mar0x/pq-4/img/pq-4/IMG_7533 copy.png

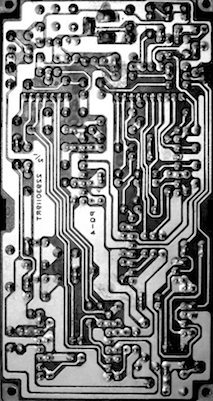
img/pq-4/IMG_7533 copy.png
