mar0x/pq-4/doc/DS-5-02A-MIDI-socket.jpg

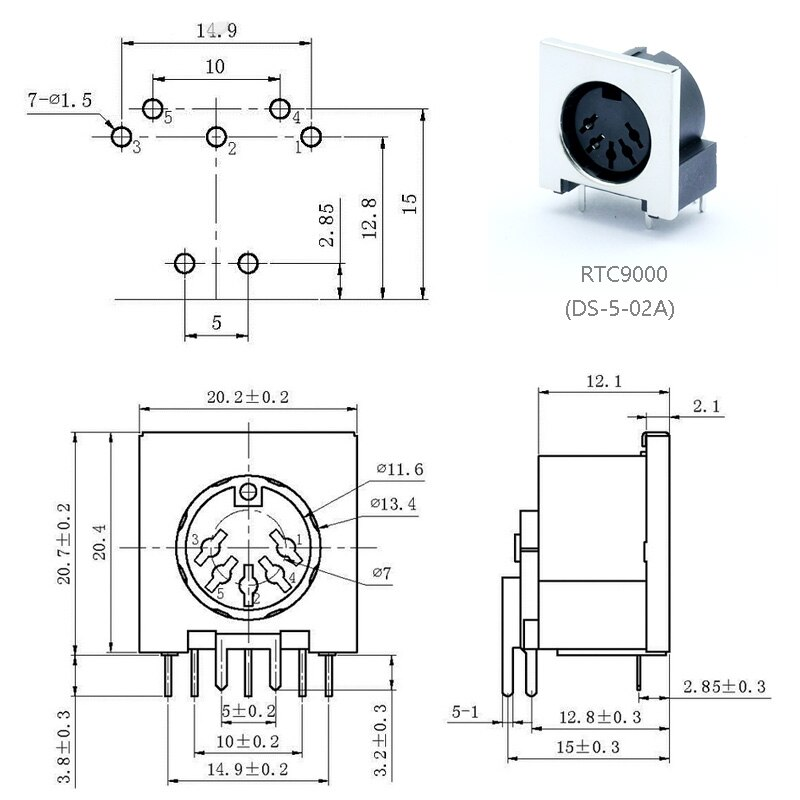
doc/DS-5-02A-MIDI-socket.jpg
