mar0x/pq-4/doc/pq-4-original.png

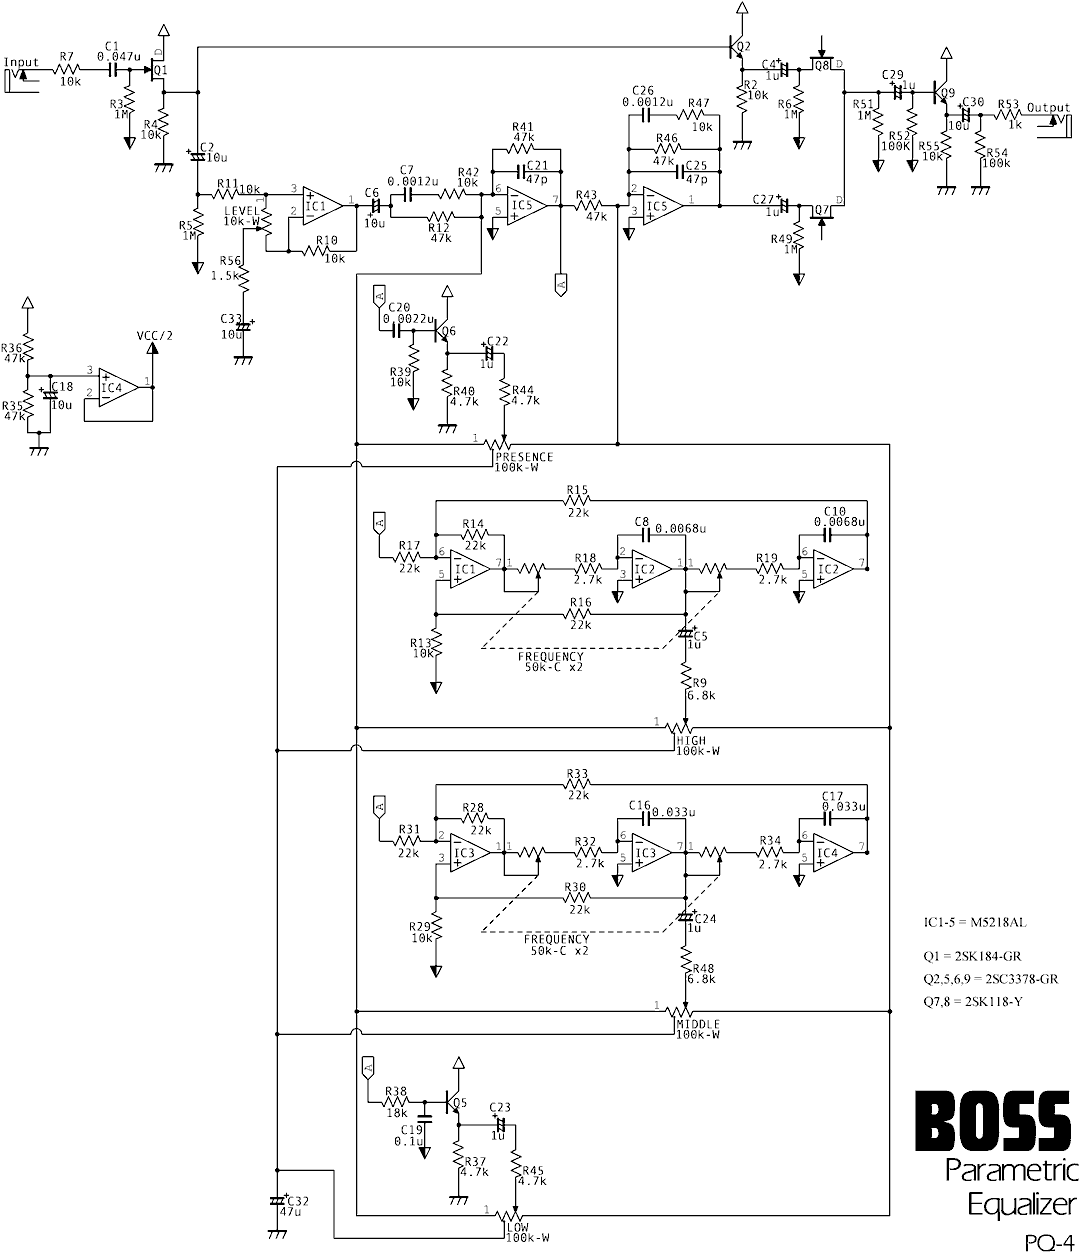
doc/pq-4-original.png
