mar0x/pq-4/img/digi_pot_20191016_101719.jpg

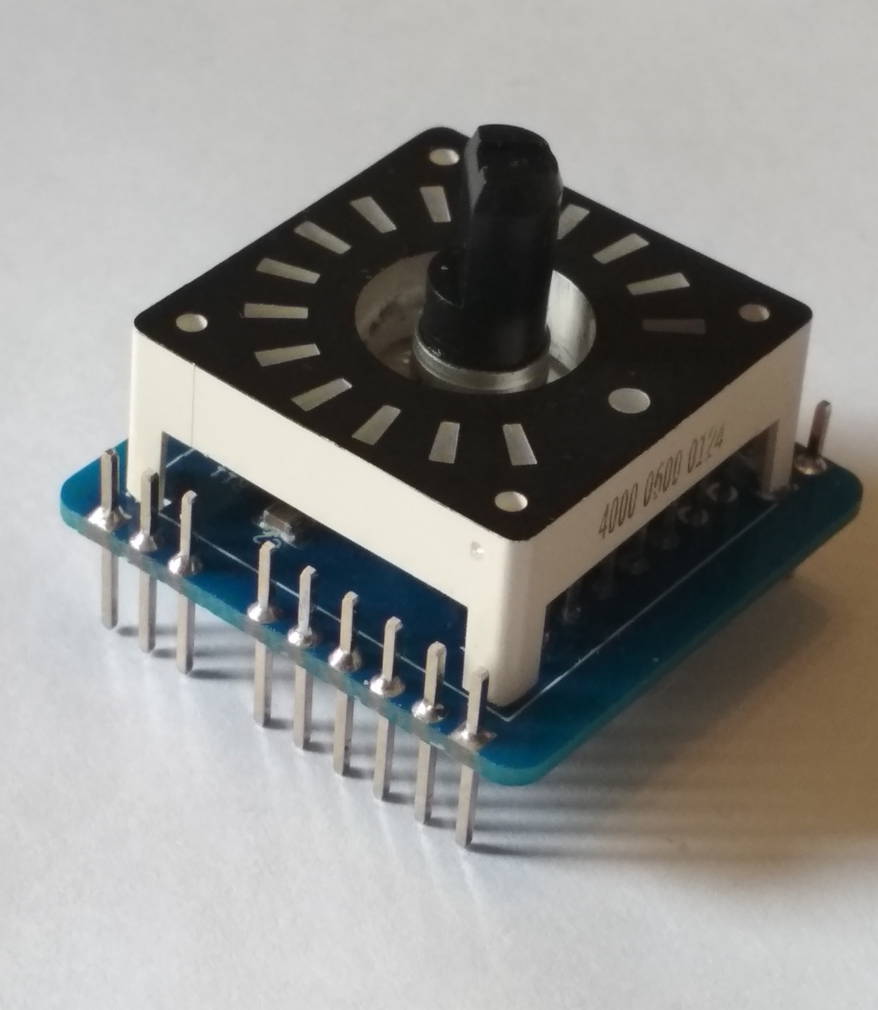
img/digi_pot_20191016_101719.jpg
