mar0x/pq-4/img/digi_pot_20191017_182157.jpg

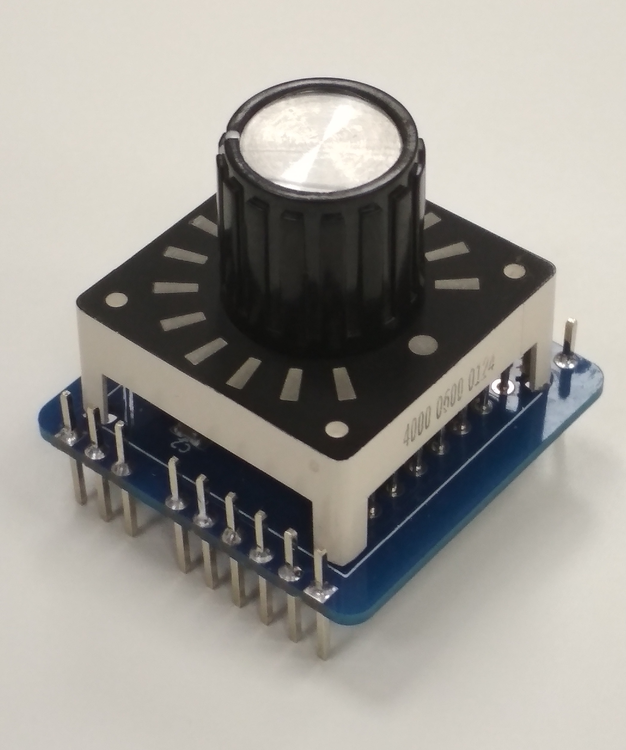
img/digi_pot_20191017_182157.jpg
