mar0x/pq-4/img/double_pot_vs_digi_pot.jpg

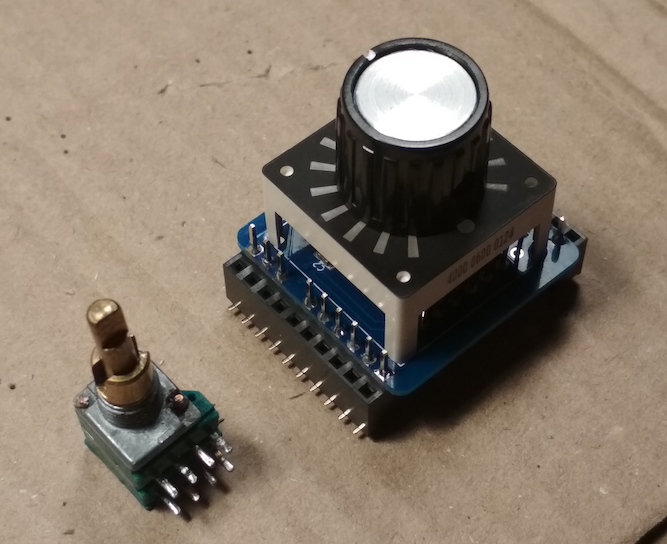
img/double_pot_vs_digi_pot.jpg
