mar0x/pq-4/img/drill.png

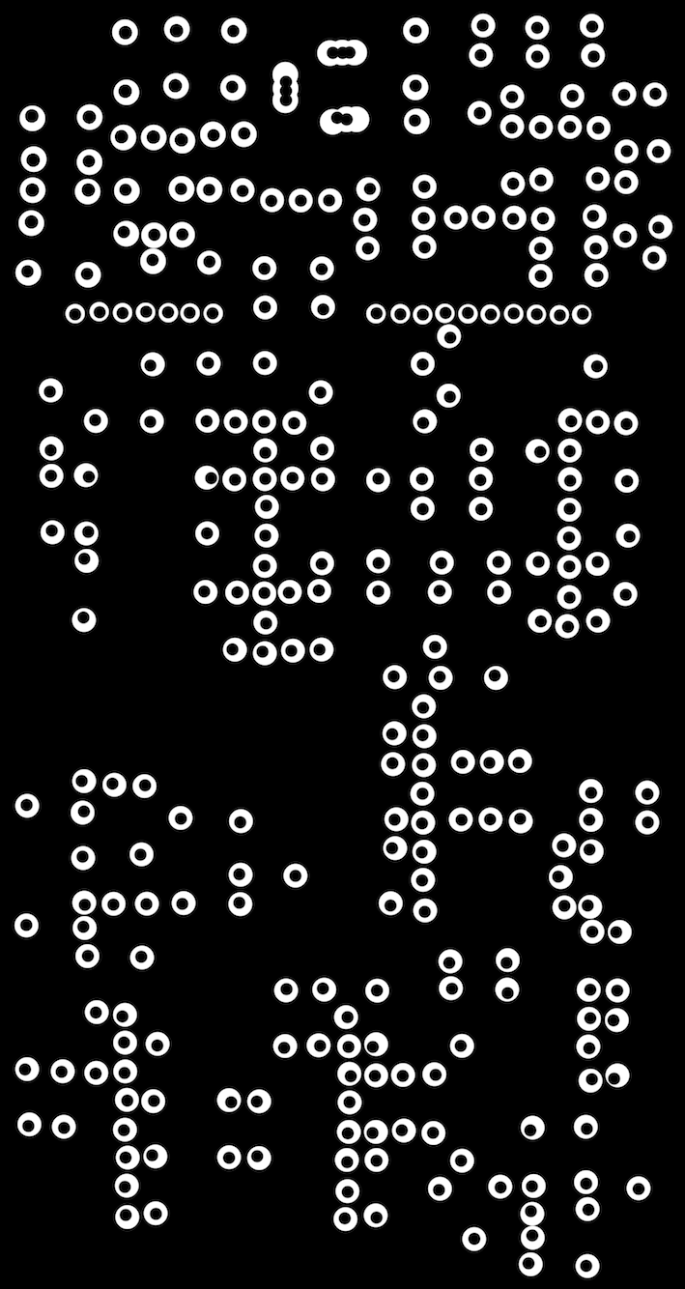
img/drill.png
