mar0x/pq-4/img/layout_v01.jpg

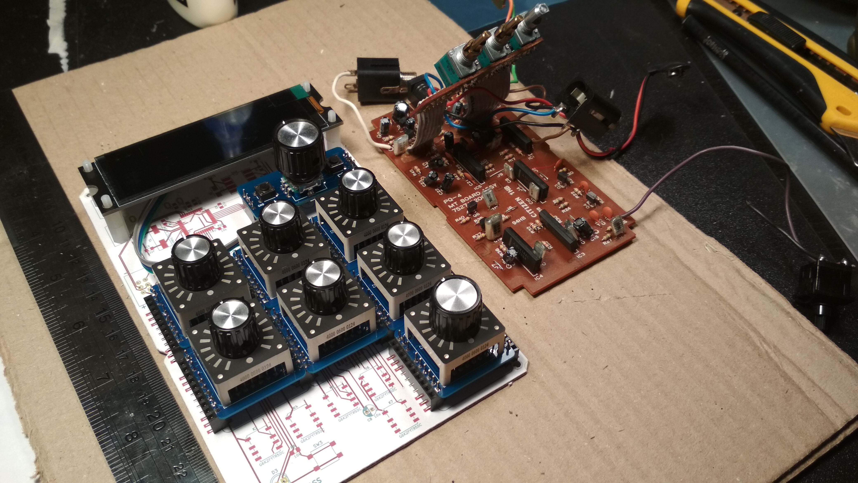
img/layout_v01.jpg
