mar0x/pq-4/img/pq-4/IMG_7537.JPG

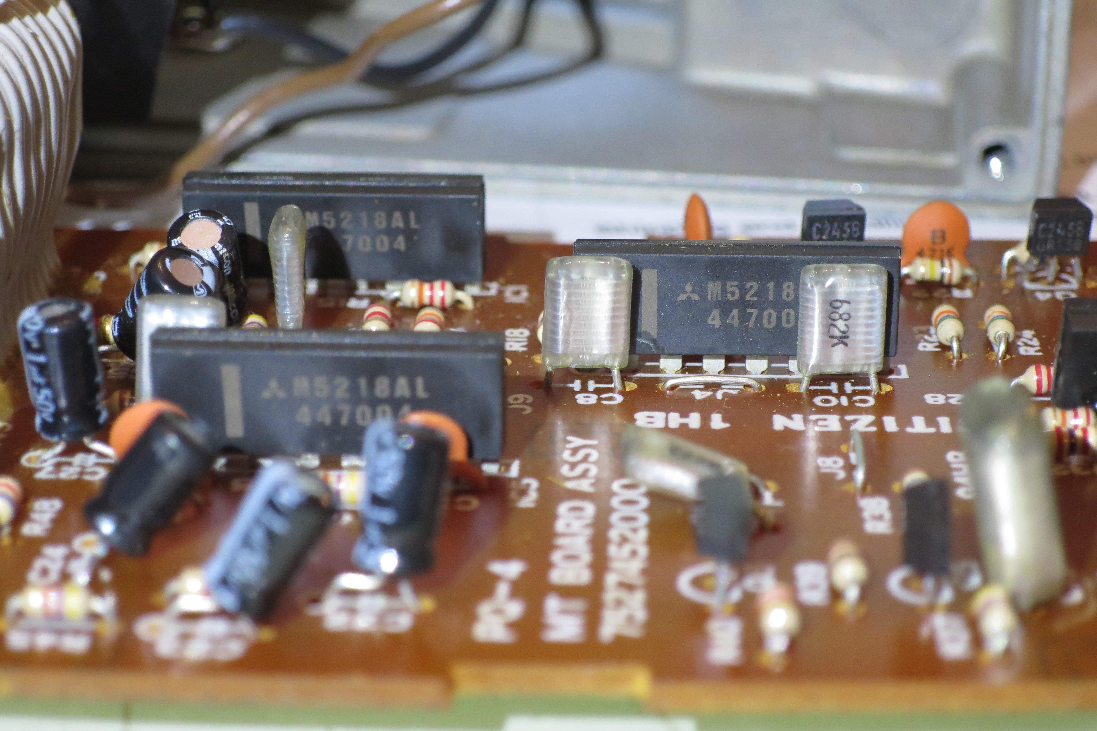
img/pq-4/IMG_7537.JPG
