mar0x/pq-4/img/pq-4/IMG_7544.JPG

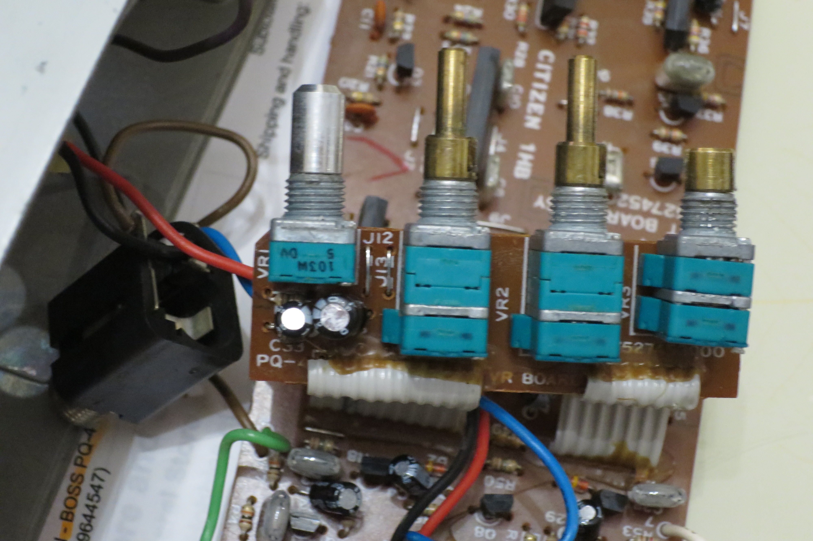
img/pq-4/IMG_7544.JPG
