mar0x/pq-4/img/pq-4/PICT0001.jpg

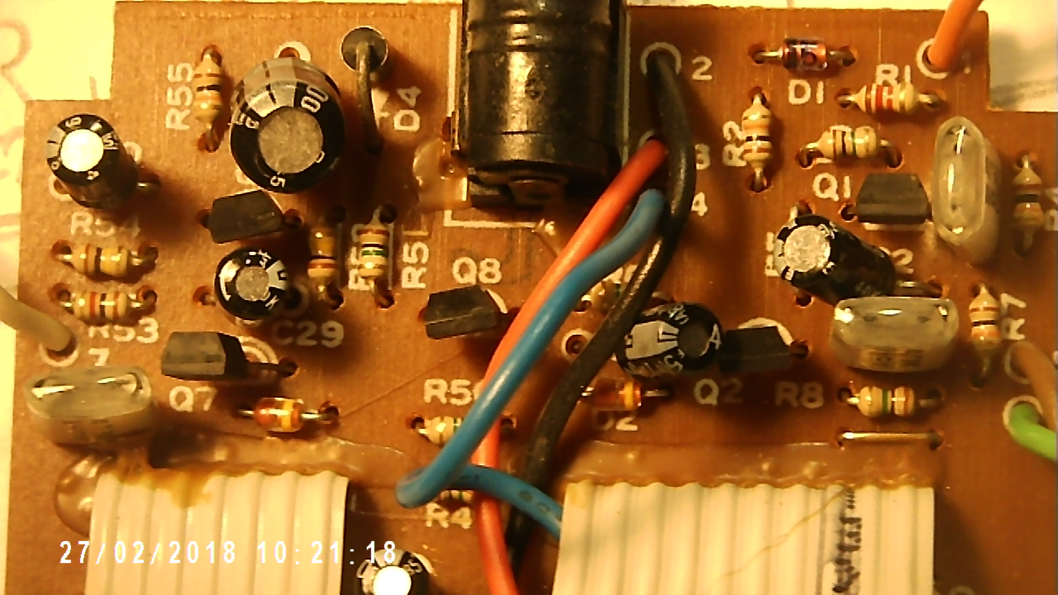
img/pq-4/PICT0001.jpg
