mar0x/pq-4/img/pq-4/PICT0008.jpg

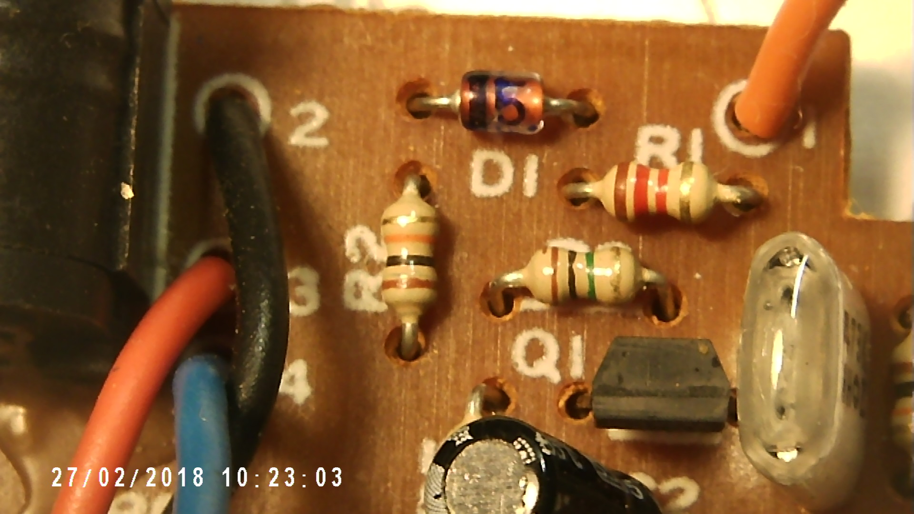
img/pq-4/PICT0008.jpg
