mar0x/pq-4/img/pq-4/PICT0014.jpg

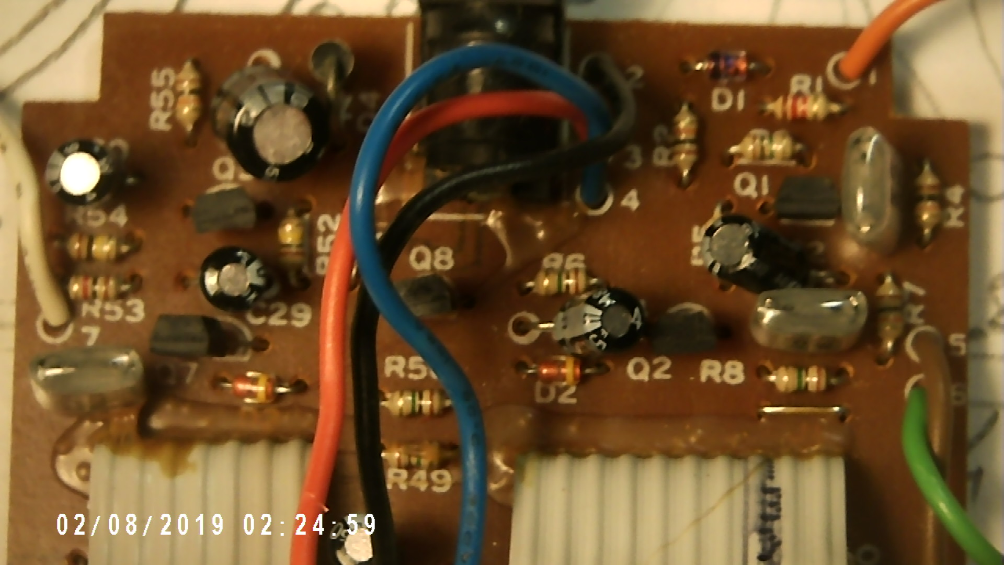
img/pq-4/PICT0014.jpg
