mar0x/pq-4/img/pq-4/PICT0015.jpg

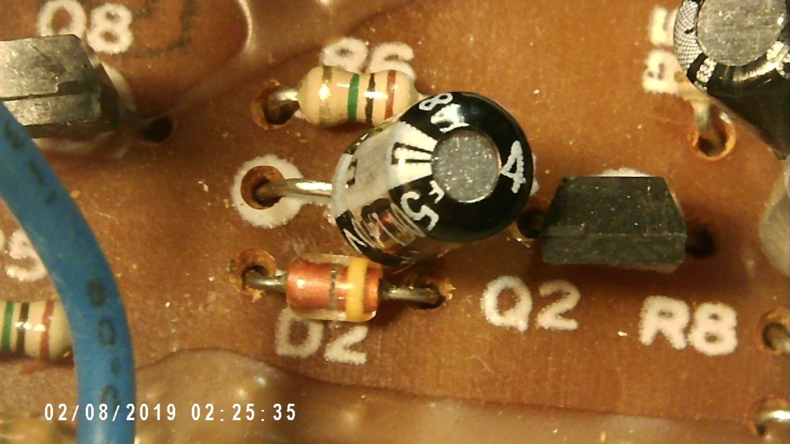
img/pq-4/PICT0015.jpg
