mar0x/pq-4/img/pq-4/PICT0018.jpg

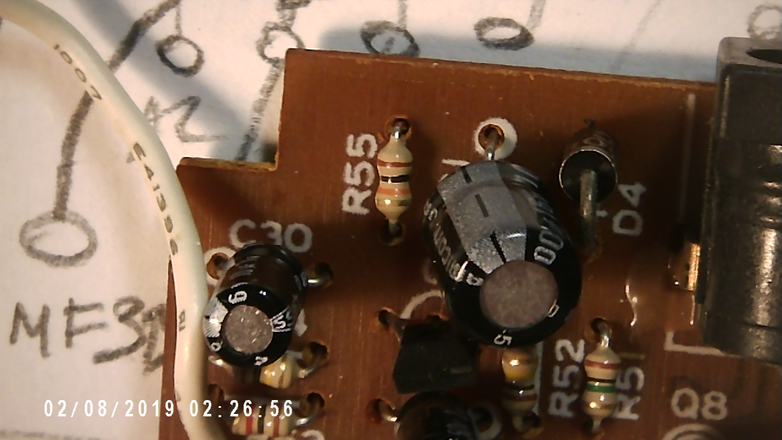
img/pq-4/PICT0018.jpg
