mar0x/pq-4/img/pq-4/PICT0020.jpg

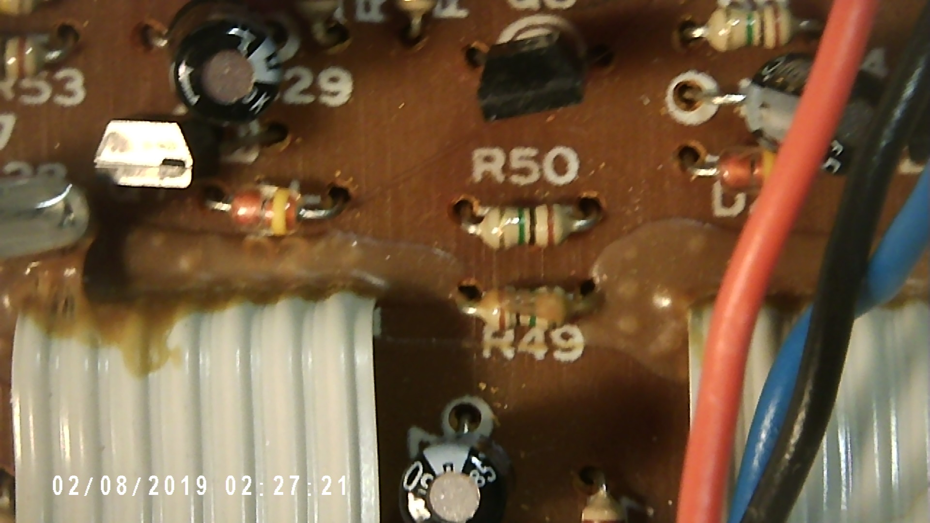
img/pq-4/PICT0020.jpg
