mar0x/pq-4/img/render/digi_pot_bottom.jpg

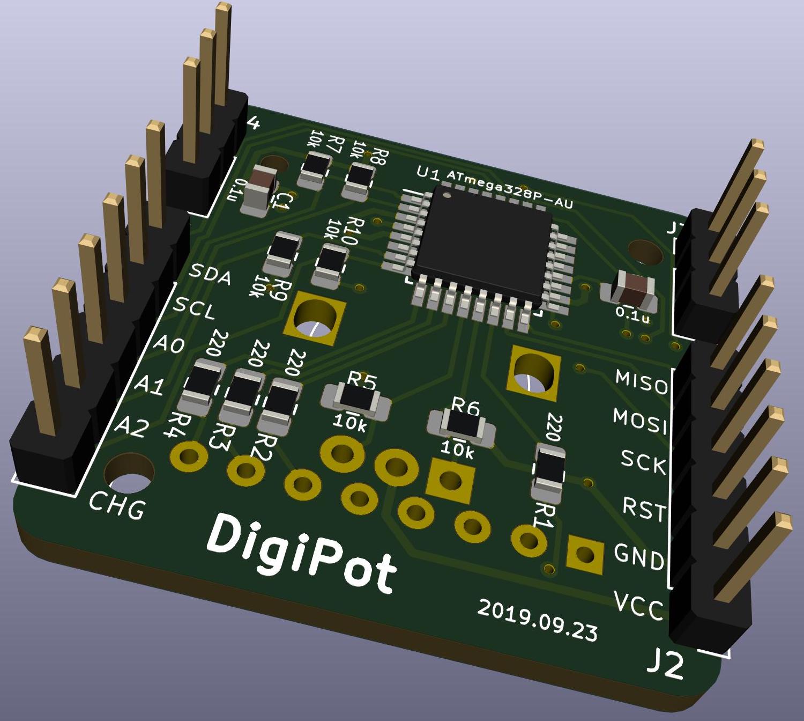
img/render/digi_pot_bottom.jpg
