mar0x/pq-4/img/render/digi_pot_render.jpg

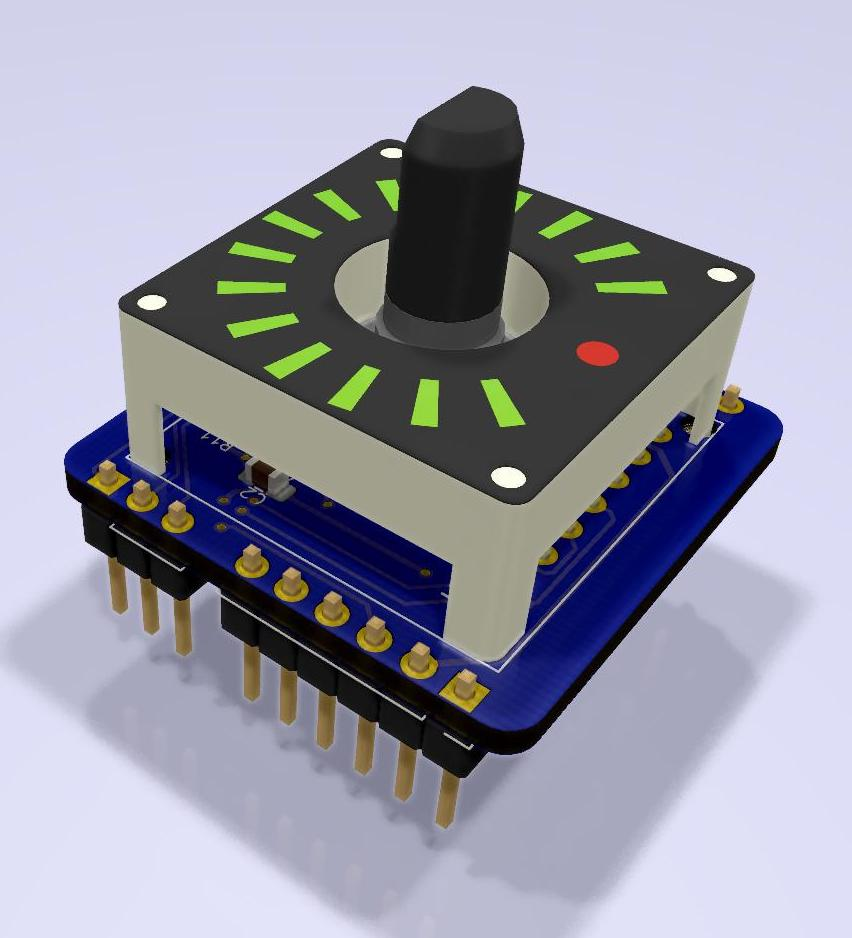
img/render/digi_pot_render.jpg
