mar0x/pq-4/img/render/digi_pot_top.jpg

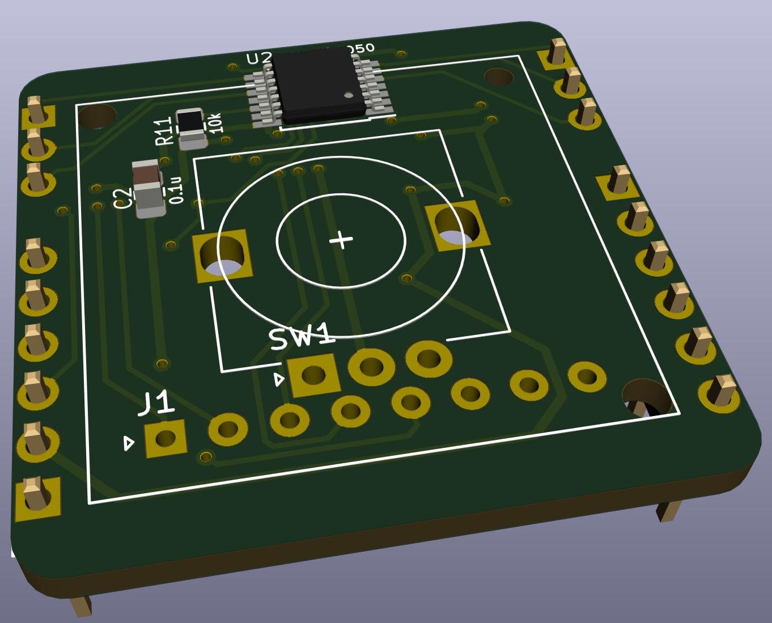
img/render/digi_pot_top.jpg
