mar0x/pq-4/img/render/enc_panel_top.jpg

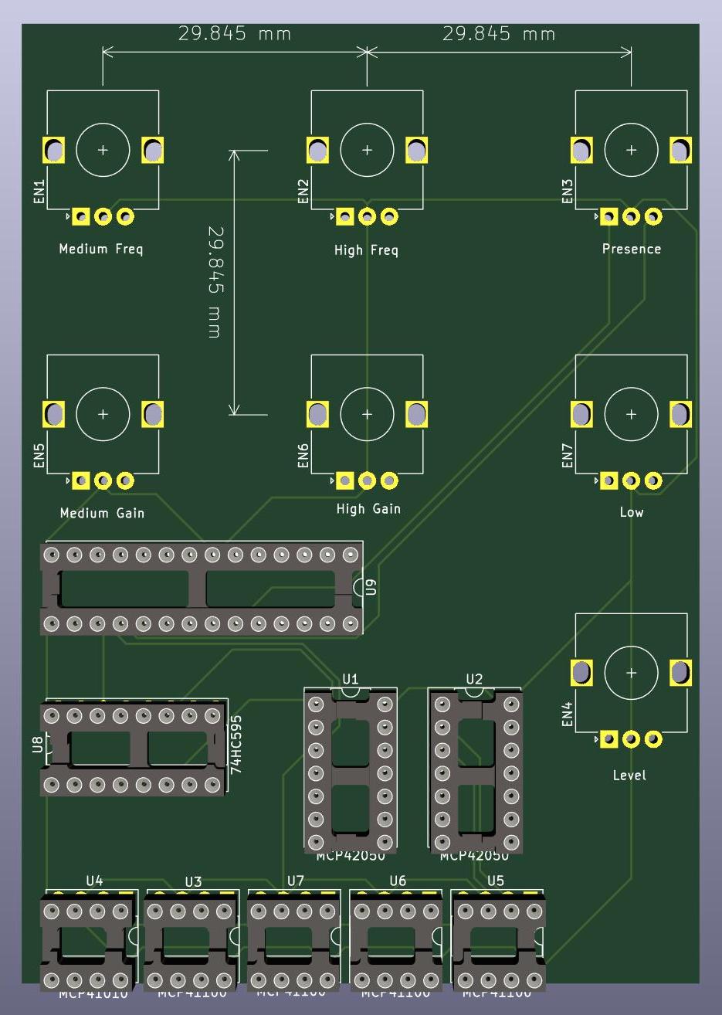
img/render/enc_panel_top.jpg
