mar0x/pq-4/img/render/eval_board_bottom.jpg

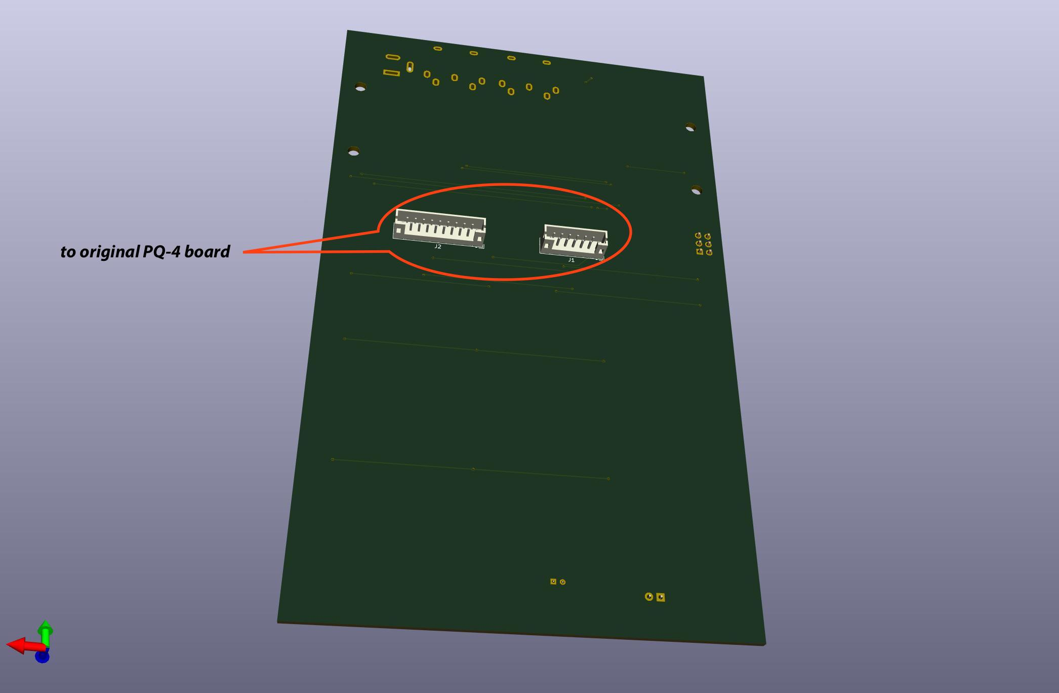
img/render/eval_board_bottom.jpg
