mar0x/pq-4/img/render/eval_board_top.jpg

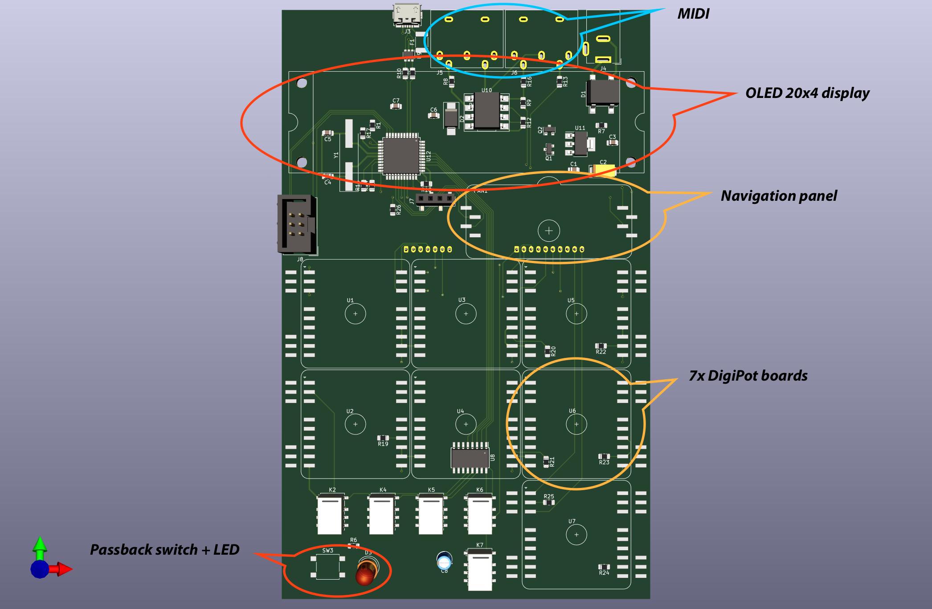
img/render/eval_board_top.jpg
