mar0x/pq-4/img/render/nav_panel_bottom.jpg

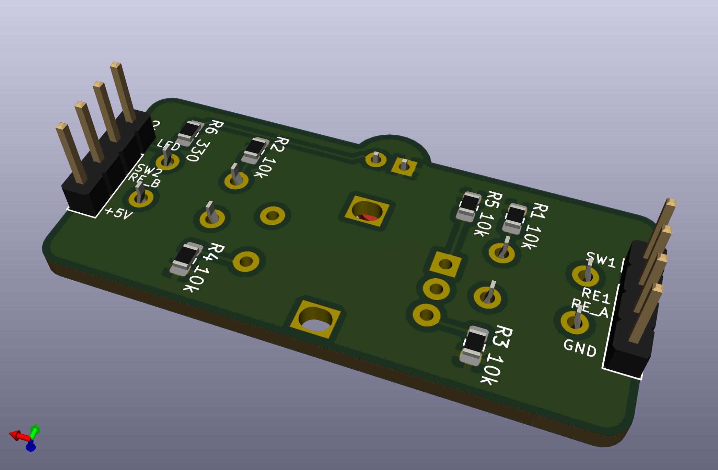
img/render/nav_panel_bottom.jpg
