mar0x/pq-4/img/render/nav_panel_top.jpg

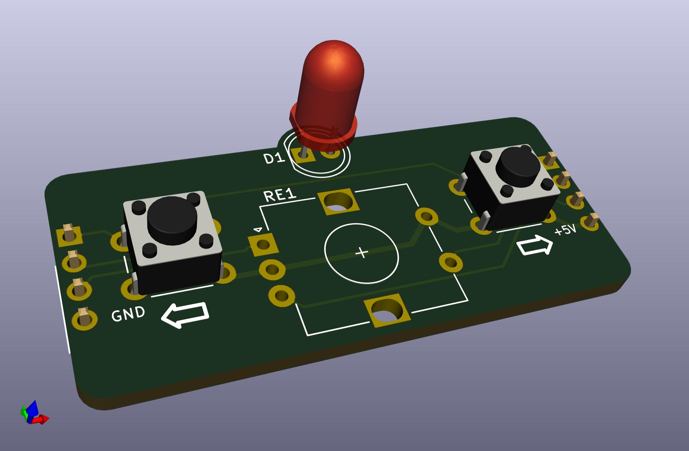
img/render/nav_panel_top.jpg
