mar0x/pq-4/doc/pq-4-replica.pdf

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

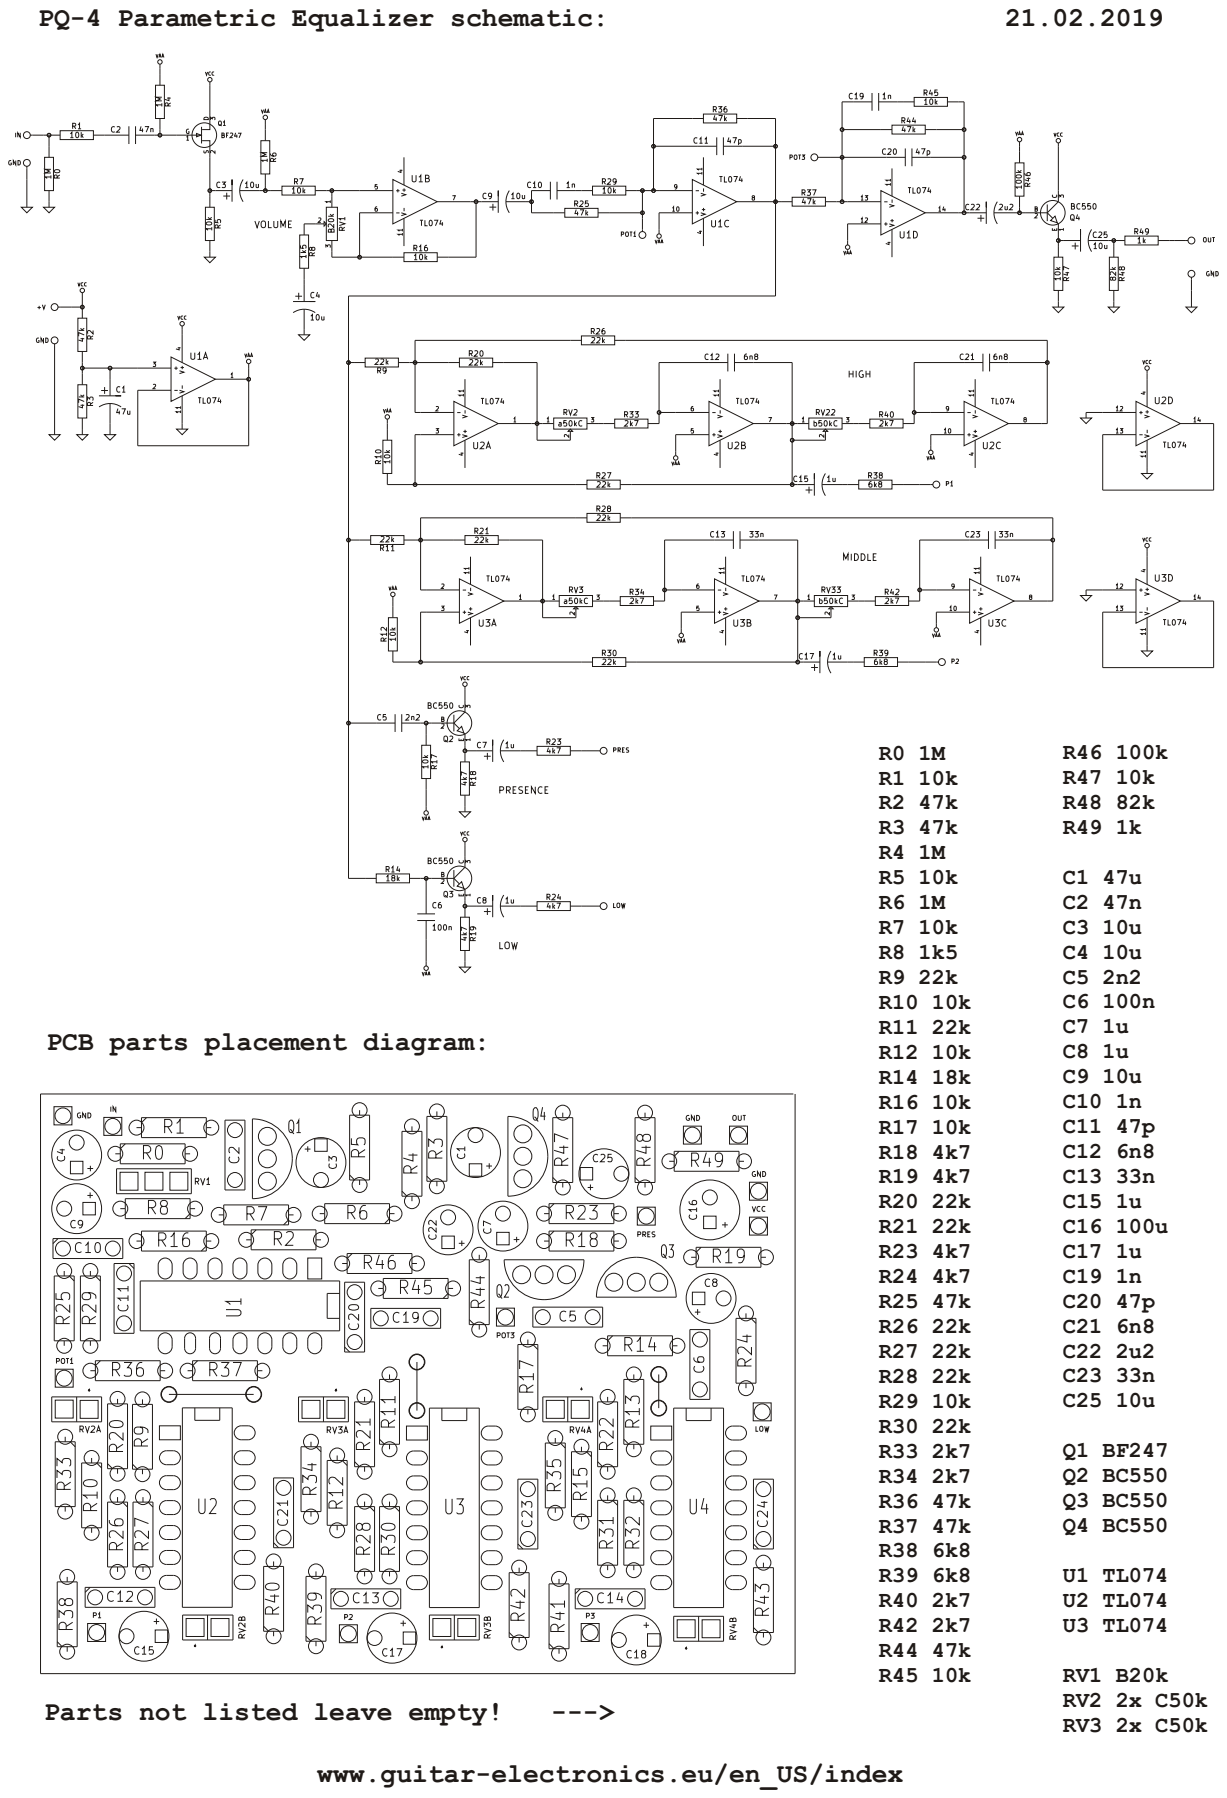
[picture p52: page 1]

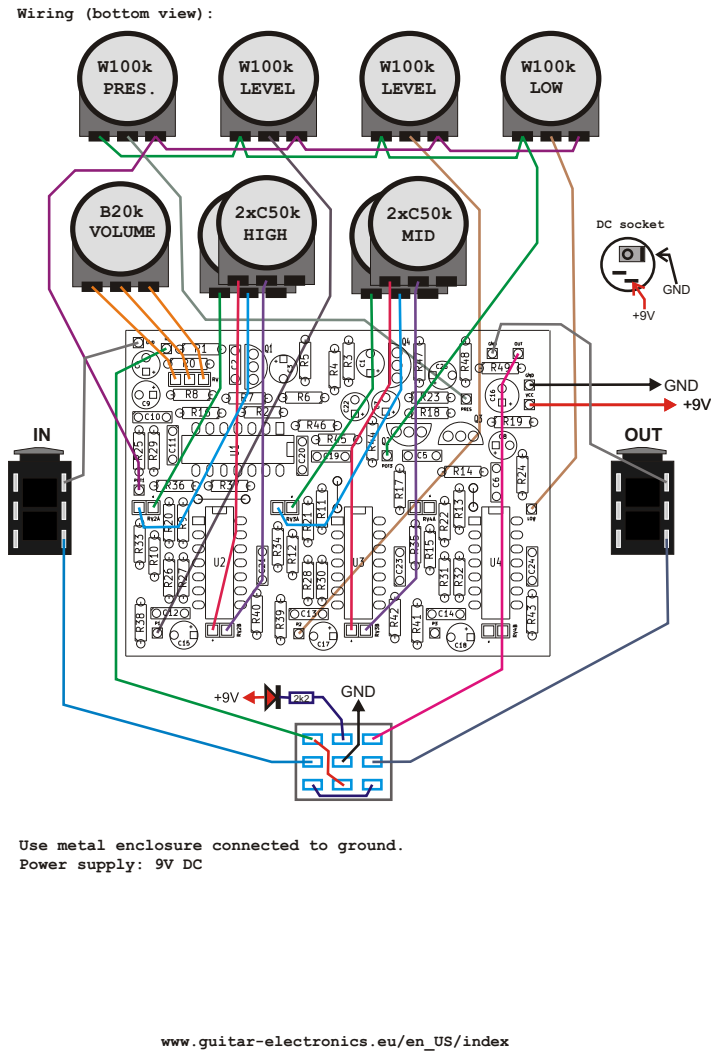
[picture p53: page 2]
W100k LEVEL; GND; 2xC50k MID; W100k PRES.; W100k LOW; B20k VOLUME; 2xC50k HIGH; OUT; DC socket

Wiring (bottom view):

Use metal enclosure connected to ground.
Power supply: 9V DC

www.guitar-electronics.eu/en_US/index

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

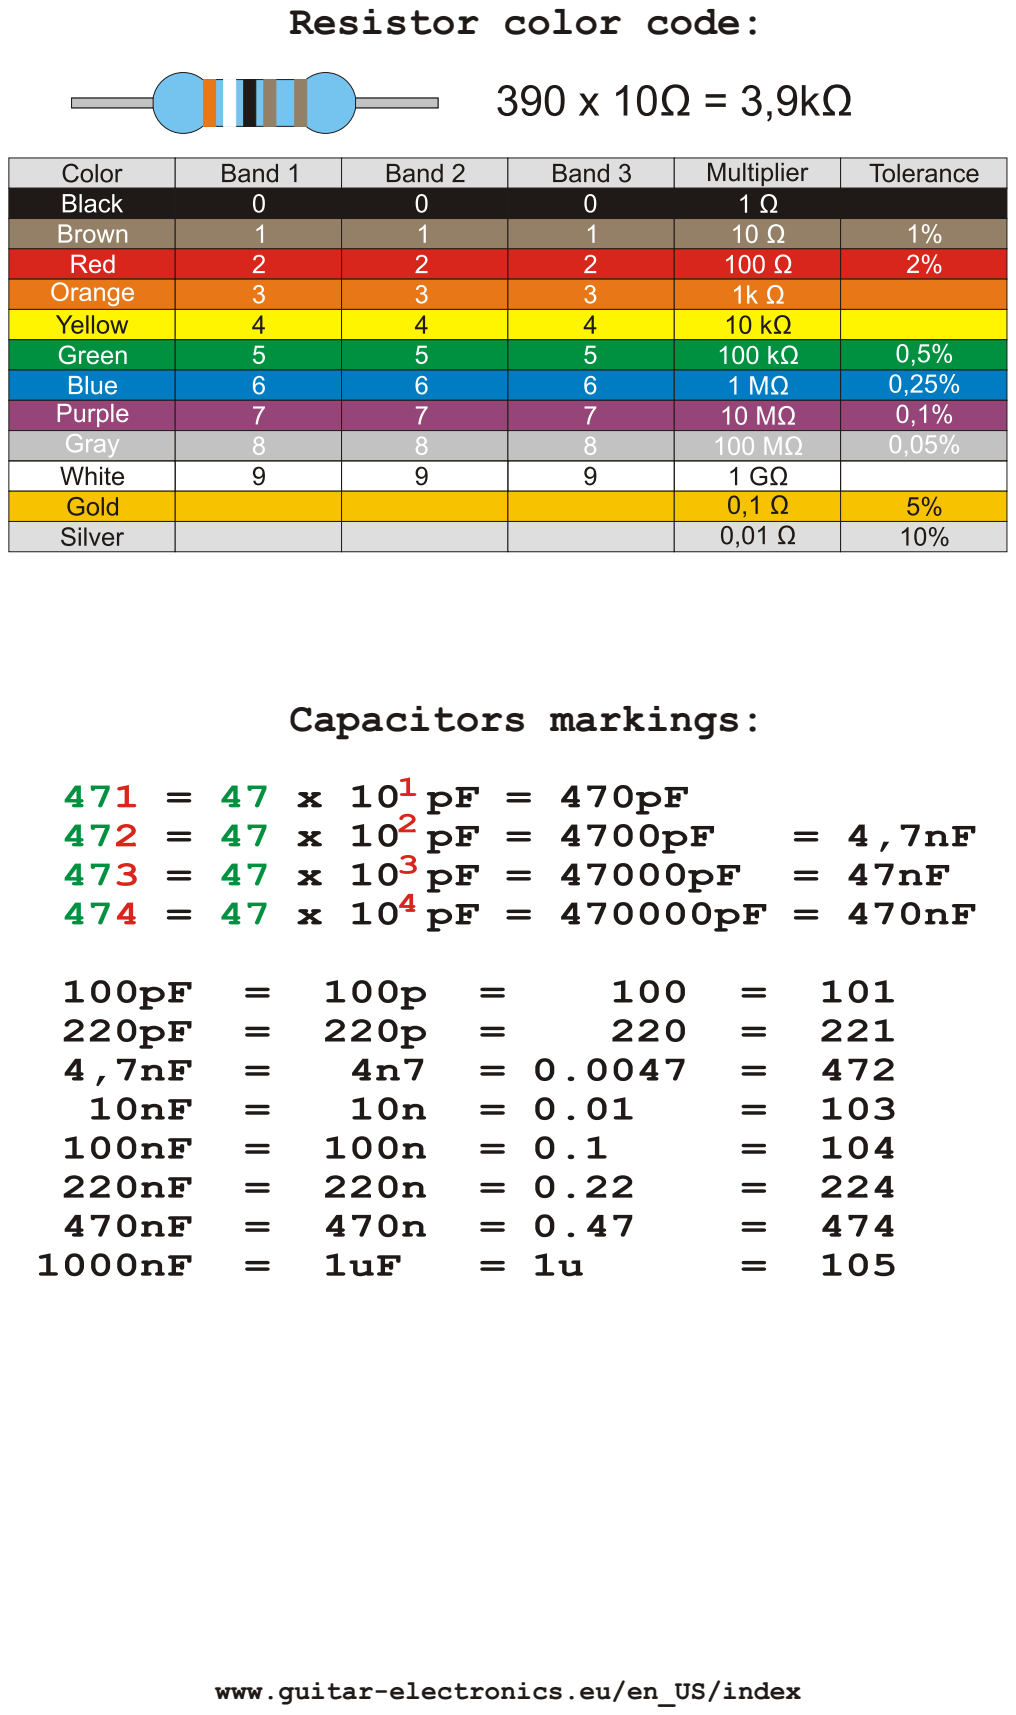
[picture p54: page 4]
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
