mar0x/pq-4/pq-4-schem.pdf

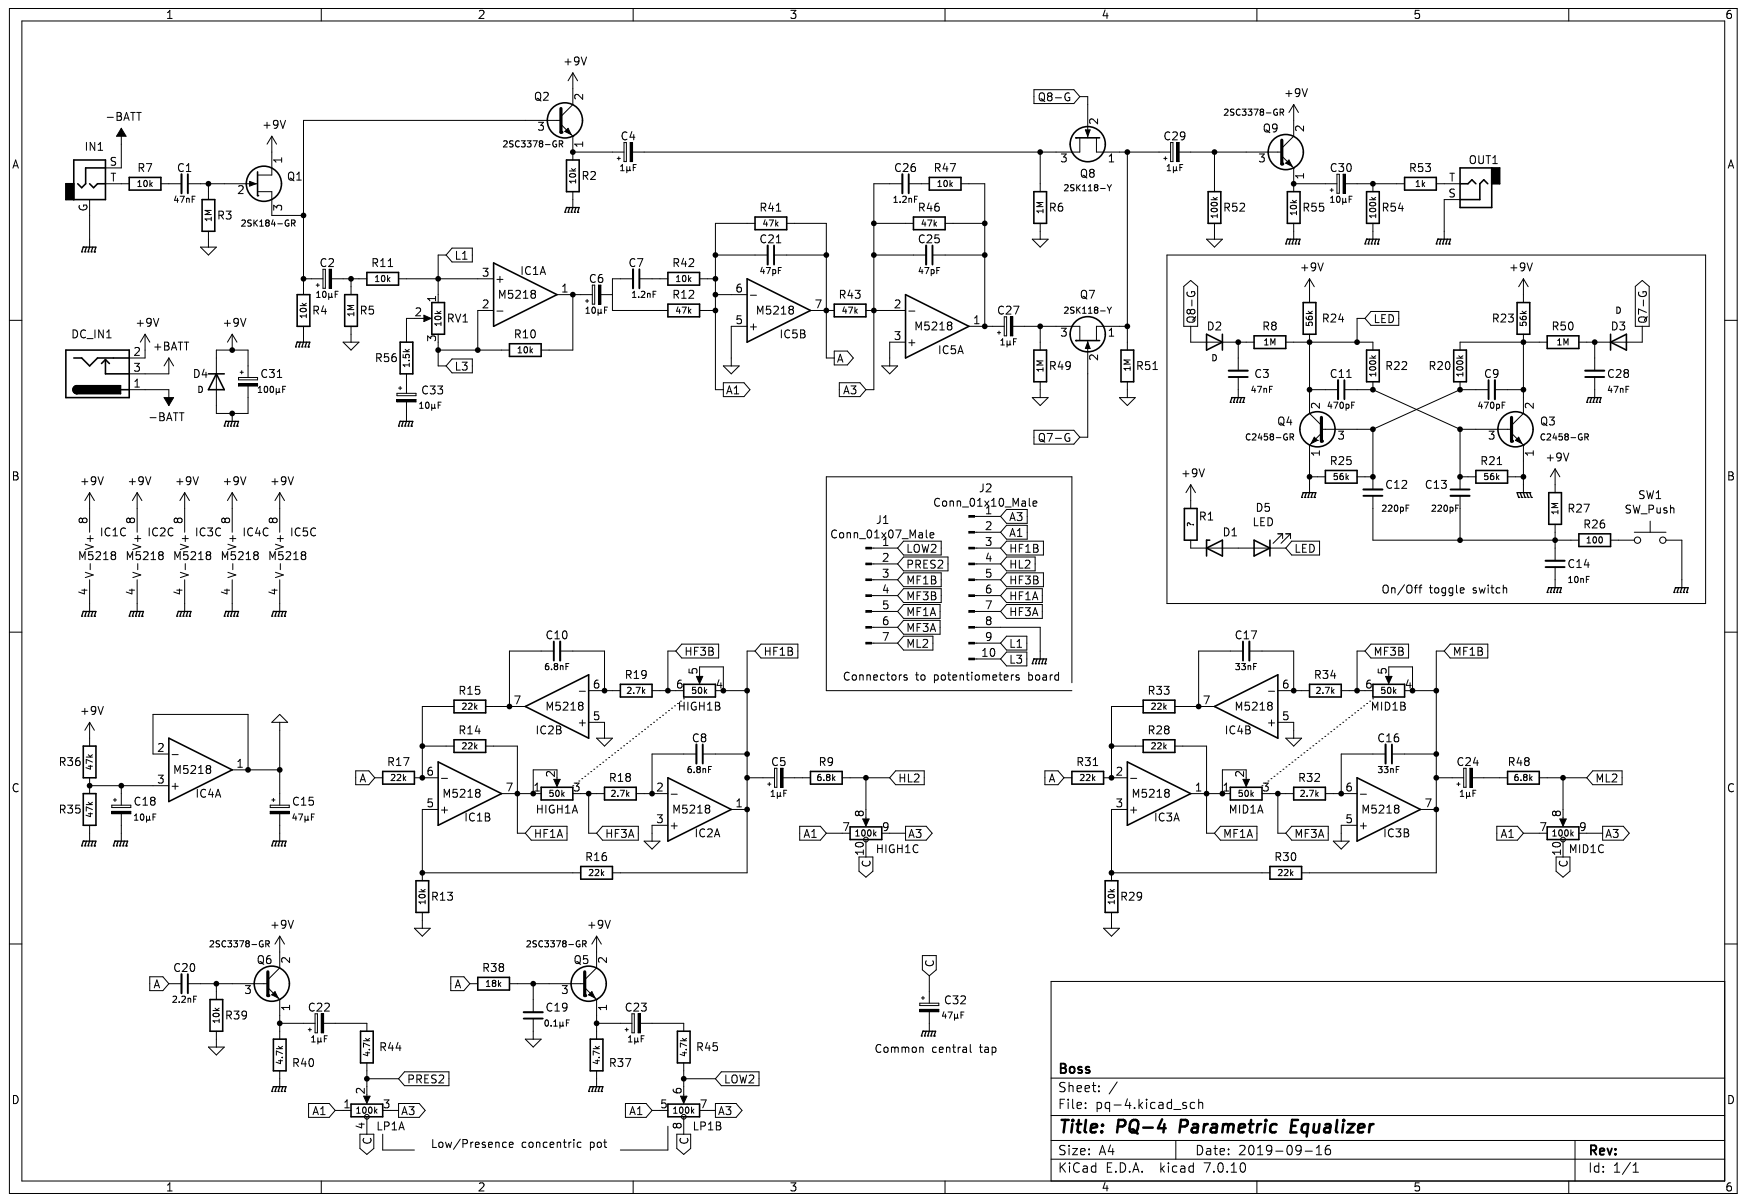
[picture p55: page 1]
