mar0x/pq-4/doc/Парам.экв 10.pdf

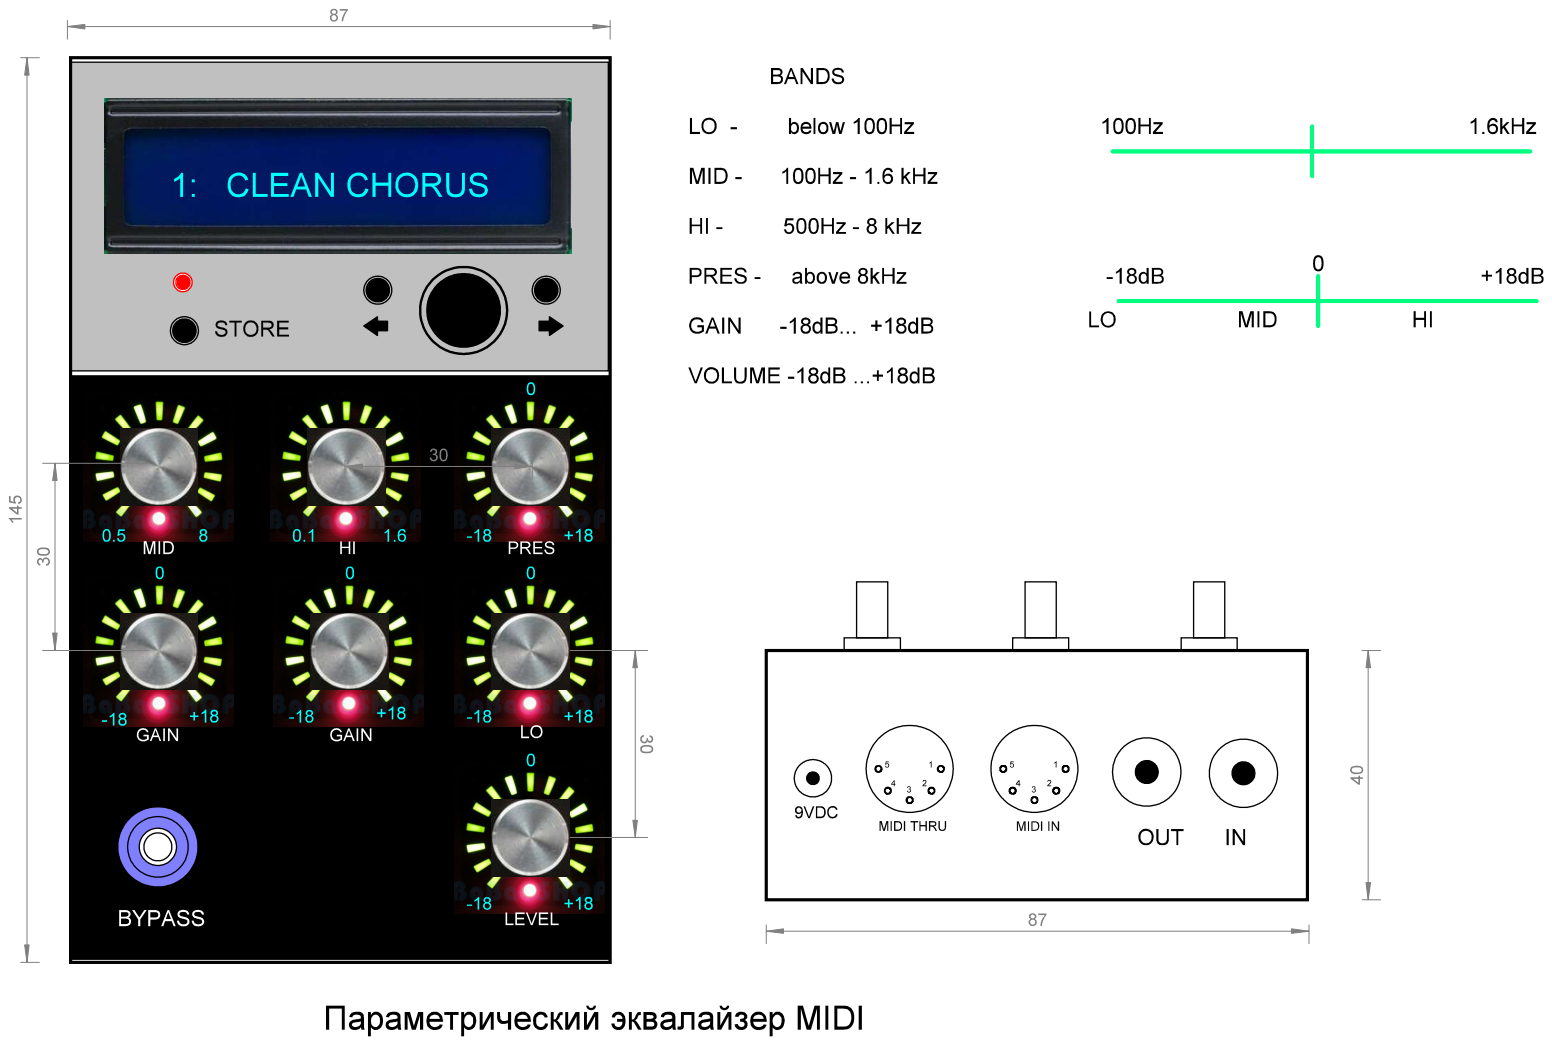
[picture p56: page 1]
