mar0x/pq-4/pot_board/pot_board.kicad_pcb

## KiCad design pot_board/pot_board.kicad_pcb (2024-01-14)

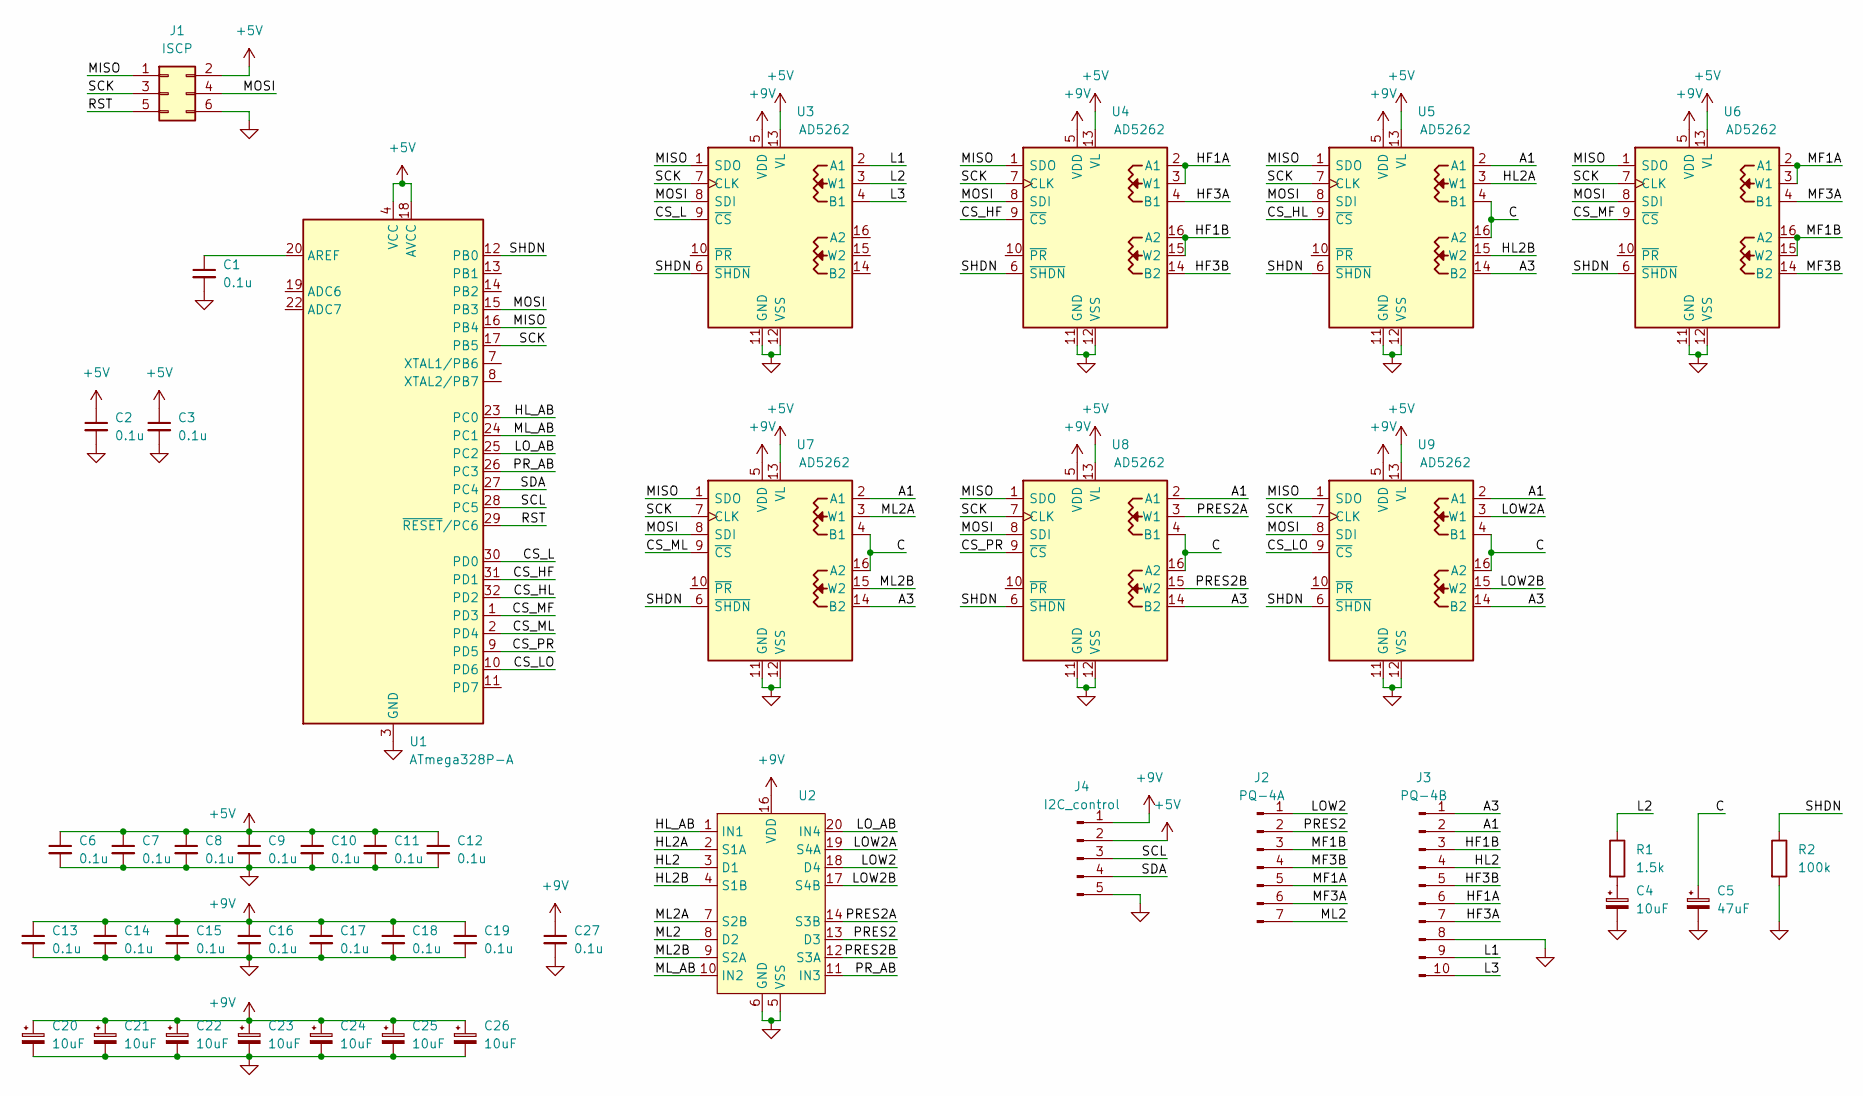
[picture p57: schematic pot_board.kicad_sch]

Parts:
C1, C2, C3, C6, C7, C8, C9, C10, C11, C12, C13, C14, C15, C16, C17, C18, C19, C27: 0.1u; C_0805_2012Metric
C4, C20, C21, C22, C23, C24, C25, C26: 10uF; CP_Radial_D4.0mm_P2.00mm
C5: 47uF; CP_Radial_D4.0mm_P2.00mm
J1: ISCP; IDC-Header_2x03_P2.54mm_Vertical
J2: PQ-4A; JST_PH_B7B-PH-K_1x07_P2.00mm_Vertical
J3: PQ-4B; JST_PH_B10B-PH-K_1x10_P2.00mm_Vertical
J4: I2C_control; JST_PH_B5B-PH-K_1x05_P2.00mm_Vertical
R1: 1.5k; R_0805_2012Metric
R2: 100k; R_0805_2012Metric
U1: ATmega328P-A; TQFP-32_7x7mm_P0.8mm
U2: TSSOP-20_4.4x6.5mm_P0.65mm
U3, U4, U5, U6, U7, U8, U9: AD5262; TSSOP-16_4.4x5mm_P0.65mm

Connections:
+5V: C2.1, C3.1, C6.1, C7.1, C8.1, C9.1, C10.1, C11.1, C12.1, J1.2, J4.2, U1.4 (VCC), U1.6 (VCC), U1.18 (AVCC), U3.13 (VL), U4.13 (VL), U5.13 (VL), U6.13 (VL), U7.13 (VL), U8.13 (VL), U9.13 (VL)
+9V: C13.1, C14.1, C15.1, C16.1, C17.1, C18.1, C19.1, C20.1, C21.1, C22.1, C23.1, C24.1, C25.1, C26.1, C27.1, J4.1, U2.16 (VDD), U3.5 (VDD), U4.5 (VDD), U5.5 (VDD), U6.5 (VDD), U7.5 (VDD), U8.5 (VDD), U9.5 (VDD)
/A1: J3.2, U5.2 (A1), U7.2 (A1), U8.2 (A1), U9.2 (A1)
/A3: J3.1, U5.14 (B2), U7.14 (B2), U8.14 (B2), U9.14 (B2)
/C: C5.1, U5.4 (B1), U5.16 (A2), U7.4 (B1), U7.16 (A2), U8.4 (B1), U8.16 (A2), U9.4 (B1), U9.16 (A2)
/CS_HF: U1.31 (PD1), U4.9 (~CS)
/CS_HL: U1.32 (PD2), U5.9 (~CS)
/CS_L: U1.30 (PD0), U3.9 (~CS)
/CS_LO: U1.10 (PD6), U9.9 (~CS)
/CS_MF: U1.1 (PD3), U6.9 (~CS)
/CS_ML: U1.2 (PD4), U7.9 (~CS)
/CS_PR: U1.9 (PD5), U8.9 (~CS)
/HF1A: J3.6, U4.2 (A1), U4.3 (W1)
/HF1B: J3.3, U4.15 (W2), U4.16 (A2)
/HF3A: J3.7, U4.4 (B1)
/HF3B: J3.5, U4.14 (B2)
/HL2: J3.4, U2.3 (D1)
/HL2A: U2.2 (S1A), U5.3 (W1)
/HL2B: U2.4 (S1B), U5.15 (W2)
/HL_AB: U1.23 (PC0), U2.1 (IN1)
/L1: J3.9, U3.2 (A1)
/L2: R1.1, U3.3 (W1)
/L3: J3.10, U3.4 (B1)
/LOW2: J2.1, U2.18 (D4)
/LOW2A: U2.19 (S4A), U9.3 (W1)
/LOW2B: U2.17 (S4B), U9.15 (W2)
/LO_AB: U1.25 (PC2), U2.20 (IN4)
/MF1A: J2.5, U6.2 (A1), U6.3 (W1)
/MF1B: J2.3, U6.15 (W2), U6.16 (A2)
/MF3A: J2.6, U6.4 (B1)
/MF3B: J2.4, U6.14 (B2)
/MISO: J1.1, U1.16 (PB4), U3.1 (SDO), U4.1 (SDO), U5.1 (SDO), U6.1 (SDO), U7.1 (SDO), U8.1 (SDO), U9.1 (SDO)
/ML2: J2.7, U2.8 (D2)
/ML2A: U2.7 (S2B), U7.3 (W1)
/ML2B: U2.9 (S2A), U7.15 (W2)
/ML_AB: U1.24 (PC1), U2.10 (IN2)
/MOSI: J1.4, U1.15 (PB3), U3.8 (SDI), U4.8 (SDI), U5.8 (SDI), U6.8 (SDI), U7.8 (SDI), U8.8 (SDI), U9.8 (SDI)
/PRES2: J2.2, U2.13 (D3)
/PRES2A: U2.14 (S3B), U8.3 (W1)
/PRES2B: U2.12 (S3A), U8.15 (W2)
/PR_AB: U1.26 (PC3), U2.11 (IN3)
/RST: J1.5, U1.29 (~RESET/PC6)
/SCK: J1.3, U1.17 (PB5), U3.7 (CLK), U4.7 (CLK), U5.7 (CLK), U6.7 (CLK), U7.7 (CLK), U8.7 (CLK), U9.7 (CLK)
/SCL: J4.3, U1.28 (PC5)
/SDA: J4.4, U1.27 (PC4)
/SHDN: R2.1, U1.12 (PB0), U3.6 (~SHDN), U4.6 (~SHDN), U5.6 (~SHDN), U6.6 (~SHDN), U7.6 (~SHDN), U8.6 (~SHDN), U9.6 (~SHDN)
GND: C1.2, C2.2, C3.2, C4.2, C5.2, C6.2, C7.2, C8.2, C9.2, C10.2, C11.2, C12.2, C13.2, C14.2, C15.2, C16.2, C17.2, C18.2, C19.2, C20.2, C21.2, C22.2, C23.2, C24.2, C25.2, C26.2, C27.2, J1.6, J3.8, J4.5, R2.2, U1.3 (GND), U1.5 (GND), U1.21 (GND), U2.5 (VSS), U2.6 (GND), U3.11 (GND), U3.12 (VSS), U4.11 (GND), U4.12 (VSS), U5.11 (GND), U5.12 (VSS), U6.11 (GND), U6.12 (VSS), U7.11 (GND), U7.12 (VSS), U8.11 (GND), U8.12 (VSS), U9.11 (GND), U9.12 (VSS)
unnamed: C4.1, R1.2
unnamed: C1.1, U1.20 (AREF)

Board: 2 copper layers, 42 parts (2 on the bottom side), 49 nets, no tracks yet.
