mar0x/pq-4/pq-4/pq-4.kicad_pcb

## KiCad design pq-4/pq-4.kicad_pcb (2024-01-06)

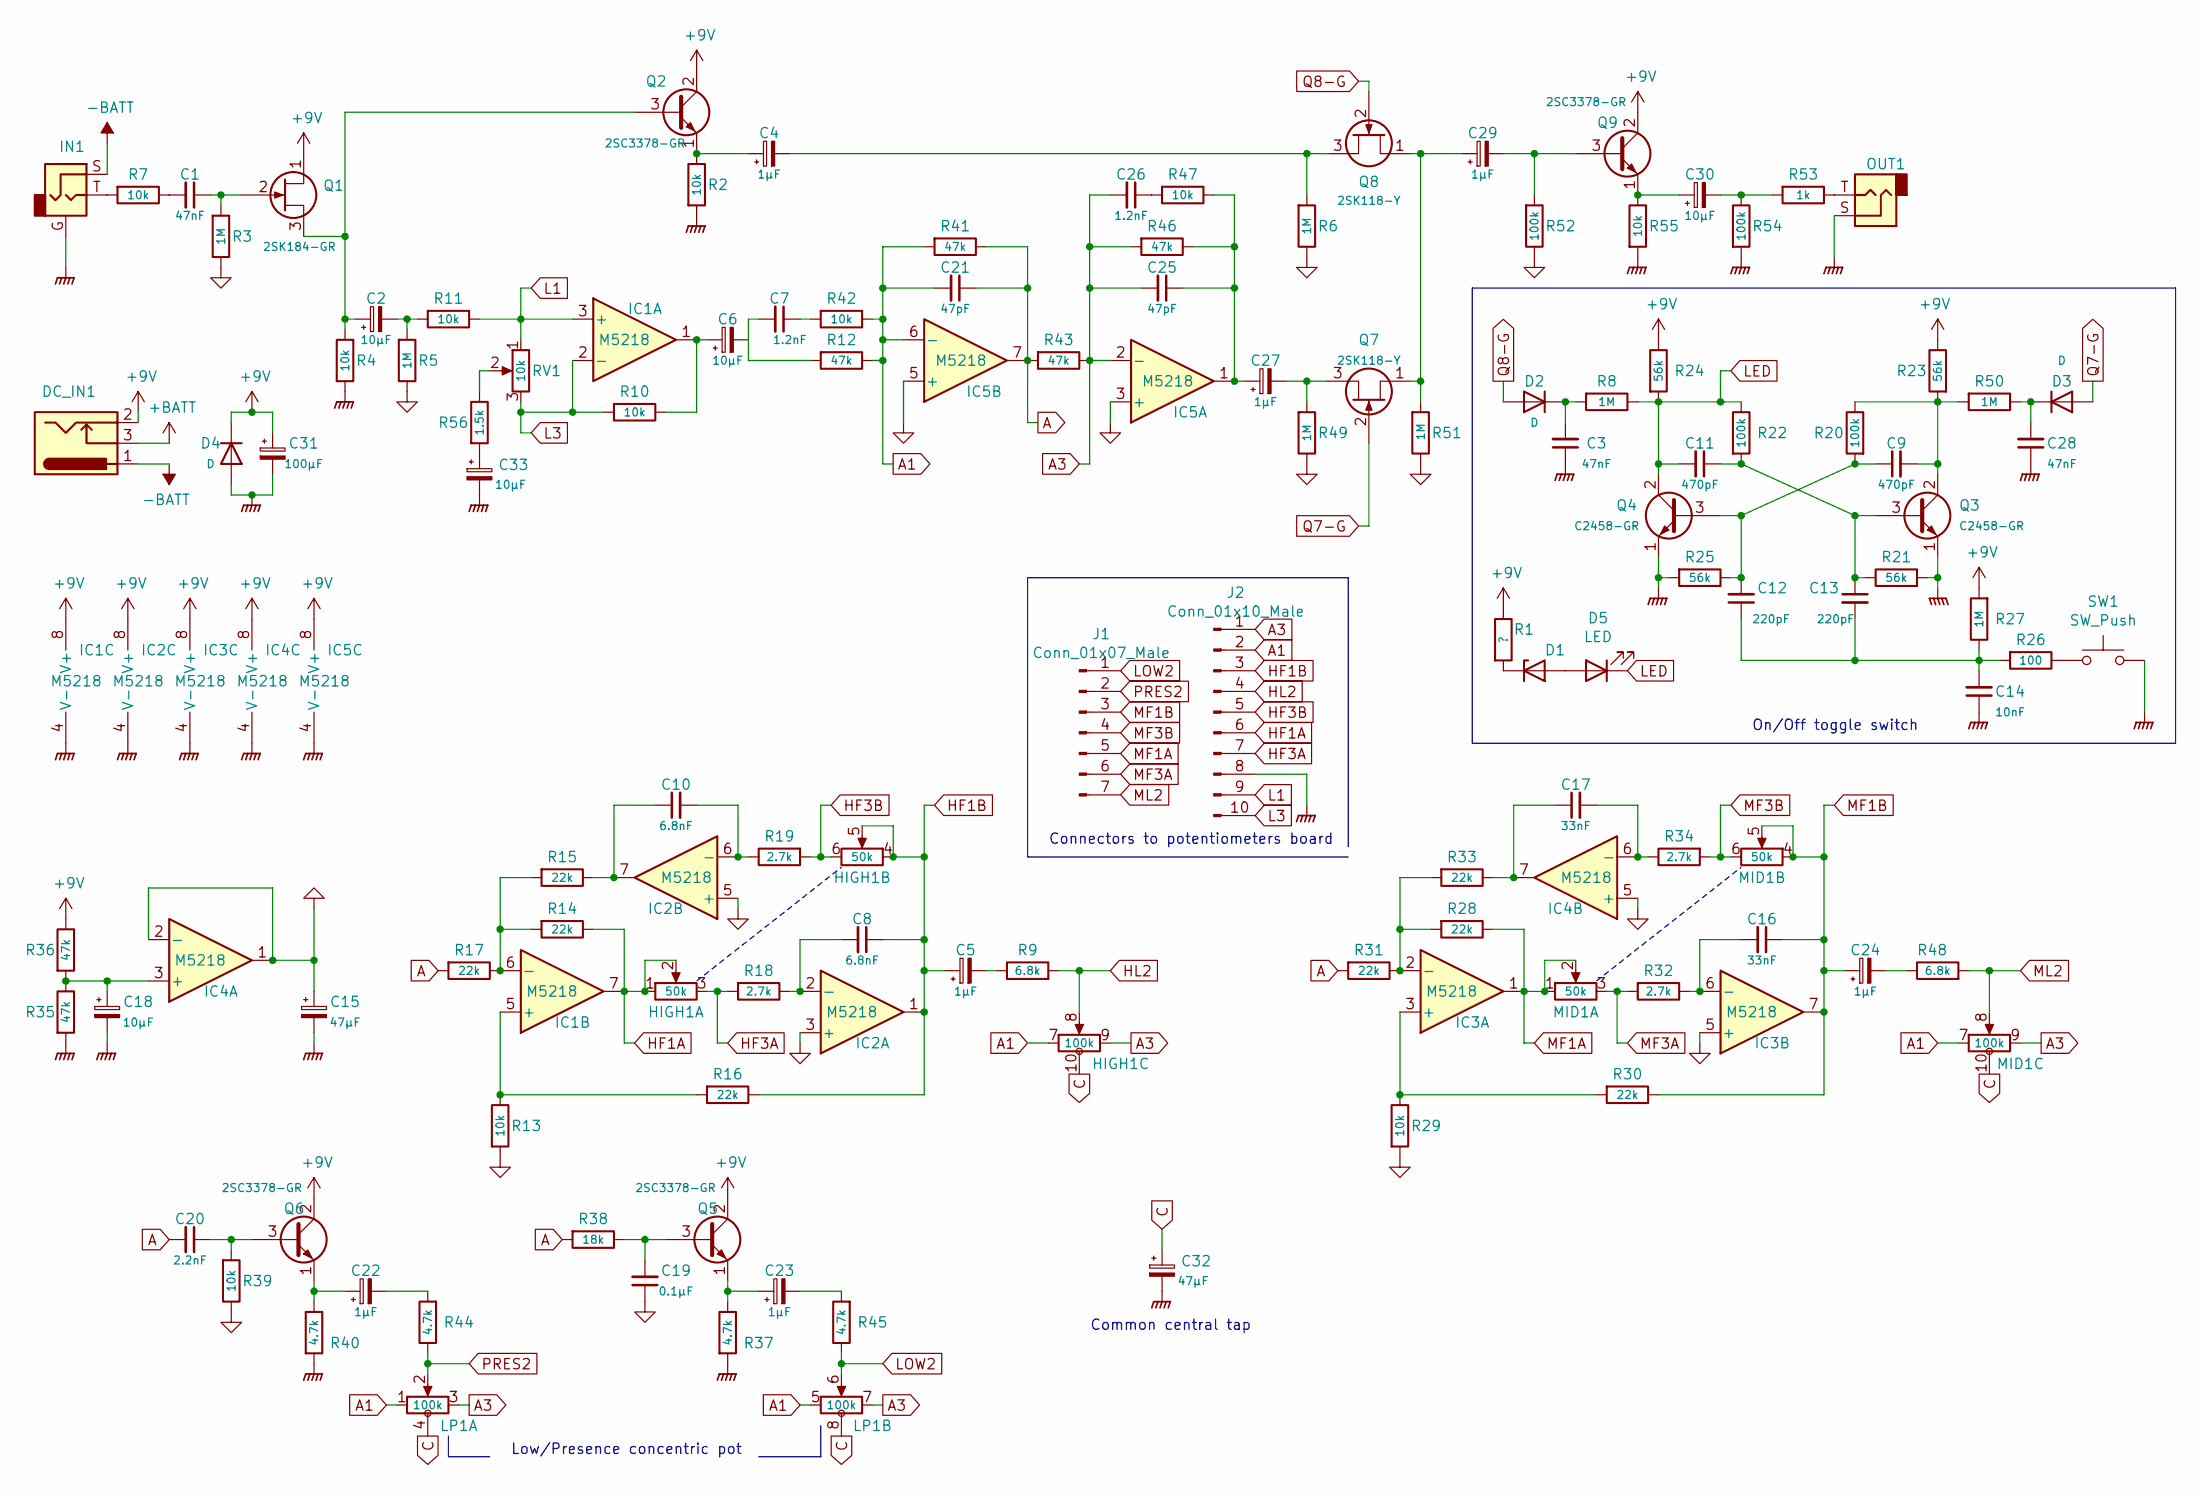
[picture p58: schematic pq-4.kicad_sch, PQ-4 Parametric Equalizer]

Parts:
C1, C3, C28: 47nF; C_Rect_L7.0mm_W2.0mm_P5.00mm
C2, C6, C18, C30, C33: 10µF; CP_Radial_D4.0mm_P5.08mm
C4, C5, C22, C23, C24, C27, C29: 1µF; CP_Radial_D4.0mm_P5.08mm
C7, C26: 1.2nF; C_Rect_L7.0mm_W2.0mm_P5.00mm
C8, C10: 6.8nF; C_Rect_L7.0mm_W2.0mm_P5.00mm
C9, C11: 470pF; C_Disc_D5.0mm_W2.5mm_P5.00mm
C12, C13: 220pF; C_Disc_D5.0mm_W2.5mm_P5.00mm
C14: 10nF; C_Rect_L7.0mm_W2.0mm_P5.00mm
C15, C32: 47µF; CP_Radial_D4.0mm_P5.08mm
C16, C17: 33nF; C_Rect_L7.0mm_W2.0mm_P5.00mm
C19: 0.1µF; C_Rect_L7.0mm_W2.0mm_P5.00mm
C20: 2.2nF; C_Rect_L7.0mm_W2.0mm_P5.00mm
C21, C25: 47pF; C_Disc_D5.0mm_W2.5mm_P5.00mm
C31: 100µF; CP_Radial_D4.0mm_P5.08mm
D1: D_Zener_Small; D_T-1_P5.08mm_Horizontal
D2, D3: D; D_T-1_P5.08mm_Horizontal
D4: D; D_5W_P5.08mm_Vertical_KathodeUp
D5: LED
DC_IN1: Barrel_Jack_Switch; BarrelJack_CUI_PJ-102AH_Horizontal
HIGH1: 50k
IC1, IC2, IC3, IC4, IC5: M5218; SIP-8_19x3mm_P2.54mm
IN1: AudioJack2_Ground
J1: Conn_01x07_Male; JST_PH_B7B-PH-K_1x07_P2.00mm_Vertical
J2: Conn_01x10_Male; JST_PH_B10B-PH-K_1x10_P2.00mm_Vertical
LP1: 100k
MID1: 50k
OUT1: AudioJack2
Q1: 2SK184-GR; TO-92S_Wide
Q2, Q5, Q6, Q9: 2SC3378-GR; TO-92S_Wide
Q3, Q4: C2458-GR; TO-92S_Wide
Q7, Q8: 2SK118-Y; TO-92S_Wide
R1: ?; R_Axial_DIN0204_L3.6mm_D1.6mm_P5.08mm_Horizontal
R2, R4, R7, R10, R11, R13, R29, R39, R42, R47, R55: 10k; R_Axial_DIN0204_L3.6mm_D1.6mm_P5.08mm_Horizontal
R3, R5, R6, R8, R27, R49, R50, R51: 1M; R_Axial_DIN0204_L3.6mm_D1.6mm_P5.08mm_Horizontal
R9, R48: 6.8k; R_Axial_DIN0204_L3.6mm_D1.6mm_P5.08mm_Horizontal
R12, R35, R36, R41, R43, R46: 47k; R_Axial_DIN0204_L3.6mm_D1.6mm_P5.08mm_Horizontal
R14, R15, R16, R17, R28, R30, R31, R33: 22k; R_Axial_DIN0204_L3.6mm_D1.6mm_P5.08mm_Horizontal
R18, R19, R32, R34: 2.7k; R_Axial_DIN0204_L3.6mm_D1.6mm_P5.08mm_Horizontal
R20, R22, R52, R54: 100k; R_Axial_DIN0204_L3.6mm_D1.6mm_P5.08mm_Horizontal
R21, R23, R24, R25: 56k; R_Axial_DIN0204_L3.6mm_D1.6mm_P5.08mm_Horizontal
R26: 100; R_Axial_DIN0204_L3.6mm_D1.6mm_P5.08mm_Horizontal
R37, R40, R44, R45: 4.7k; R_Axial_DIN0204_L3.6mm_D1.6mm_P5.08mm_Horizontal
R38: 18k; R_Axial_DIN0204_L3.6mm_D1.6mm_P5.08mm_Horizontal
R53: 1k; R_Axial_DIN0204_L3.6mm_D1.6mm_P5.08mm_Horizontal
R56: 1.5k; R_Axial_DIN0204_L3.6mm_D1.6mm_P5.08mm_Horizontal
RV1: 10k
SW1: SW_Push

Connections:
+9V: C31.1, D4.1 (K), DC_IN1.2, IC1.8 (V+), IC2.8 (V+), IC3.8 (V+), IC4.8 (V+), IC5.8 (V+), Q1.1 (D), Q2.2 (C), Q5.2 (C), Q6.2 (C), Q9.2 (C), R1.1, R23.1, R24.1, R27.2, R36.1
+BATT: DC_IN1.3
-BATT: DC_IN1.1, IN1.S
A: C20.2, C21.1, IC5.7, R17.2, R31.2, R38.2, R41.1, R43.2
A1: C21.2, HIGH1.7, IC5.6 (-), J2.2, LP1.1 (5), LP1.5, MID1.7, R12.1, R41.2, R42.1
A3: C25.2, C26.2, HIGH1.9, IC5.2 (-), J2.1, LP1.3 (7), LP1.7, MID1.9, R43.1, R46.2
C: C32.1, HIGH1.10 (Central_tap), LP1.4 (Central_tap), LP1.8 (Central_tap), MID1.10 (Central_tap)
GNDPWR: C3.1, C14.1, C15.2, C18.2, C28.1, C31.2, C32.2, C33.2, D4.2 (A), IC1.4 (V-), IC2.4 (V-), IC3.4 (V-), IC4.4 (V-), IC5.4 (V-), IN1.G, J2.8, OUT1.S, Q3.1 (E), Q4.1 (E), R2.2, R4.2, R21.2, R25.2, R35.2, R37.2, R40.2, R54.2, R55.2, SW1.2
HF1A: HIGH1.1 (5), HIGH1.2 (6), IC1.7, J2.6, R14.1
HF1B: C5.1, C8.1, HIGH1.4, HIGH1.5, IC2.1, J2.3, R16.1
HF3A: HIGH1.3 (7), J2.7, R18.2
HF3B: HIGH1.6, J2.5, R19.2
HL2: HIGH1.8, J2.4, R9.2
L1: IC1.3 (+), J2.9, R11.1, RV1.1
L3: IC1.2 (-), J2.10, R10.2, RV1.3
LED: C11.2, D5.1 (K), Q4.2 (C), R8.1, R22.1, R24.2
LOW2: J1.1, LP1.6, R45.1
MF1A: IC3.1, J1.5, MID1.1 (5), MID1.2 (6), R28.1
MF1B: C16.1, C24.1, IC3.7, J1.3, MID1.4, MID1.5, R30.1
MF3A: J1.6, MID1.3 (7), R32.2
MF3B: J1.4, MID1.6, R34.2
ML2: J1.7, MID1.8, R48.2
unnamed: C1.1, Q1.2 (G), R3.2
unnamed: C1.2, R7.1
unnamed: C2.1, Q1.3 (S), Q2.3 (B), R4.1
unnamed: C2.2, R5.2, R11.2
unnamed: C3.2, D2.1 (K), R8.2
unnamed: C4.1, Q2.1 (E), R2.1
unnamed: C4.2, Q8.3 (S), R6.2
unnamed: C5.2, R9.1
unnamed: C6.1, IC1.1, R10.1
unnamed: C7.1, R42.2
unnamed: C8.2, IC2.2 (-), R18.1
unnamed: C9.2, Q3.2 (C), R20.1, R23.2, R50.2
unnamed: C10.1, IC2.7, R15.1
unnamed: C10.2, IC2.6 (-), R19.1
unnamed: C11.1, C13.1, Q3.3 (B), R21.1, R22.2
unnamed: C12.1, C13.2, C14.2, R26.2, R27.1
unnamed: C9.1, C12.2, Q4.3 (B), R20.2, R25.1
unnamed: C16.2, IC3.6 (-), R32.1
unnamed: C17.1, IC4.7, R33.1
unnamed: C17.2, IC4.6 (-), R34.1
unnamed: C18.1, IC4.3 (+), R35.1, R36.2
unnamed: C19.2, Q5.3 (B), R38.1
unnamed: C20.1, Q6.3 (B), R39.2
unnamed: C22.1, Q6.1 (E), R40.1
unnamed: C22.2, R44.2
unnamed: C23.1, Q5.1 (E), R37.1
unnamed: C23.2, R45.2
unnamed: C24.2, R48.1
unnamed: C25.1, C27.1, IC5.1, R46.1, R47.1
unnamed: C26.1, R47.2
unnamed: C27.2, Q7.3 (S), R49.2
unnamed: C28.2, D3.1 (K), R50.1
unnamed: C29.1, Q7.1 (D), Q8.1 (D), R51.2
unnamed: C29.2, Q9.3 (B), R52.2
unnamed: C30.1, Q9.1 (E), R55.1
unnamed: C30.2, R53.2, R54.1
unnamed: C33.1, R56.2
unnamed: D1.1 (K), R1.2
unnamed: D1.2 (A), D5.2 (A)
unnamed: IC1.5 (+), R13.1, R16.2
unnamed: IC1.6 (-), R14.2, R15.2, R17.1
unnamed: IC3.2 (-), R28.2, R31.1, R33.2
unnamed: IC3.3 (+), R29.1, R30.2
unnamed: IN1.T, R7.2
unnamed: OUT1.T, R53.1
unnamed: R26.1, SW1.1
unnamed: R56.1, RV1.2
PRES2: J1.2, LP1.2 (6), R44.1
Q7-G: D3.2 (A), Q7.2 (G)
Q8-G: D2.2 (A), Q8.2 (G)
VCC: C15.1, C19.1, IC2.3 (+), IC2.5 (+), IC3.5 (+), IC4.1, IC4.2 (-), IC4.5 (+), IC5.3 (+), IC5.5 (+), R3.1, R5.1, R6.1, R13.2, R29.2, R39.1, R49.1, R51.1, R52.1

Notes on the sheet:
Connectors to potentiometers board
Common central tap
On/Off toggle switch
Low/Presence concentric pot

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
Board: 2 copper layers, 110 parts (0 on the bottom side), 66 nets, no tracks yet.
