mar0x/pq-4/digi_pot_eval_board/digi_pot_eval_board.kicad_pcb

## KiCad design digi_pot_eval_board/digi_pot_eval_board.kicad_pcb (2024-01-06)

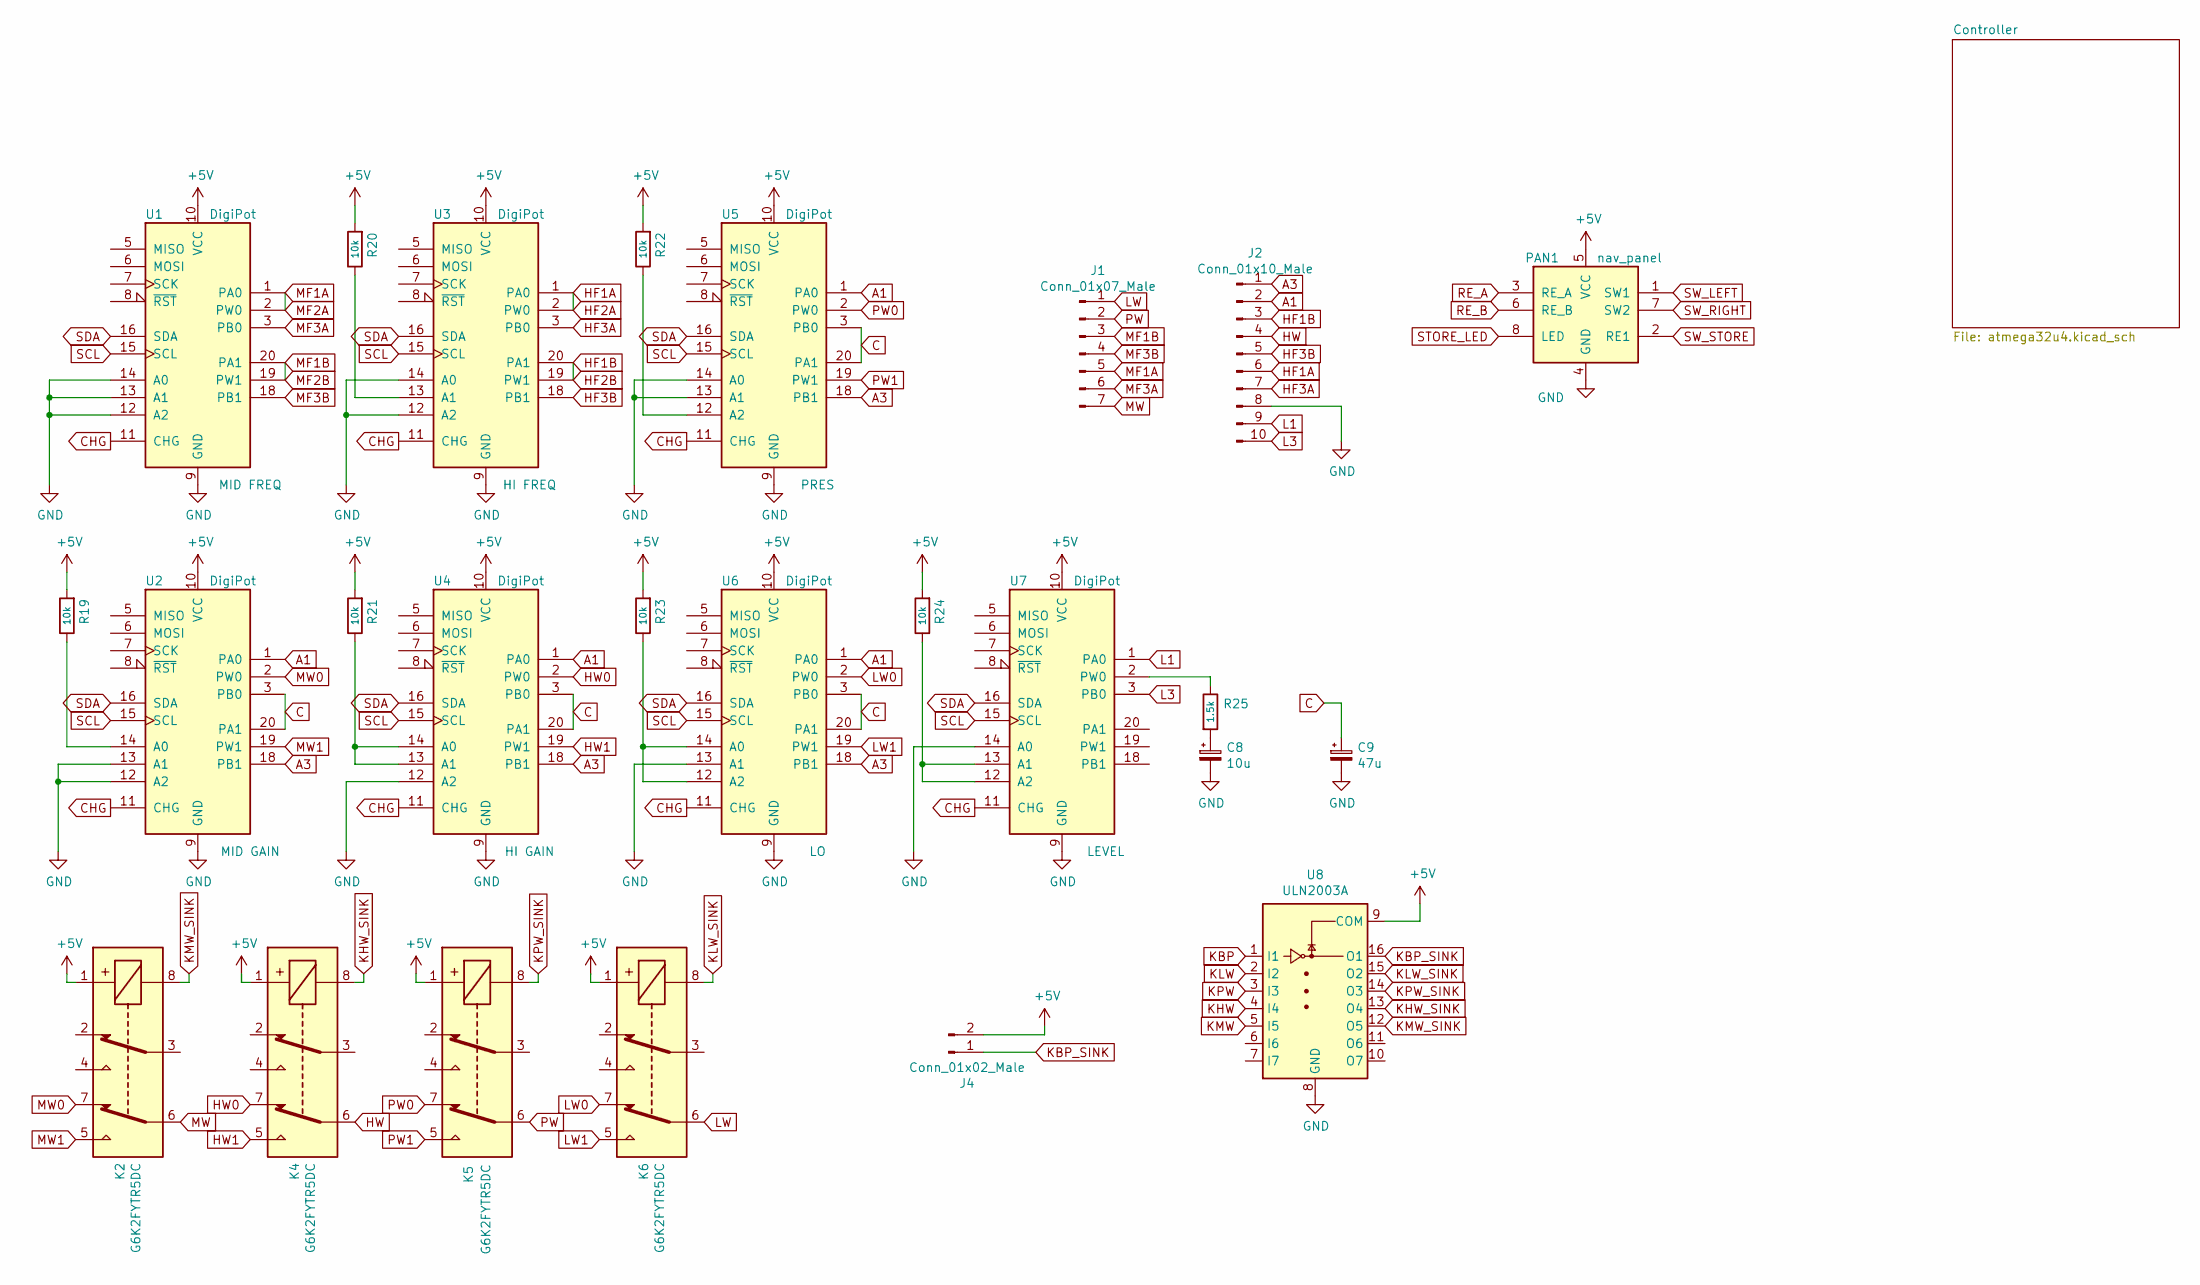
[picture p59: schematic digi_pot_eval_board.kicad_sch]

Parts:
C8: 10u; CP_Radial_D4.0mm_P2.00mm
C9: 47u; CP_Radial_D5.0mm_P2.50mm
J1: Conn_01x07_Male; JST_PH_B7B-PH-K_1x07_P2.00mm_Vertical
J2: Conn_01x10_Male; JST_PH_B10B-PH-K_1x10_P2.00mm_Vertical
J4: Conn_01x02_Male; JST_EH_B02B-EH-A_1x02_P2.50mm_Vertical
K2, K4, K5, K6: G6K2FYTR5DC; Relay_DPDT_Omron_G6K-2F-Y
PAN1: nav_panel; nav_panel_SMD
R19, R20, R21, R22, R23, R24: 10k; R_0805_2012Metric_Pad1.15x1.40mm_HandSolder
R25: 1.5k; R_0805_2012Metric_Pad1.15x1.40mm_HandSolder
U1, U2, U3, U4, U5, U6, U7: DigiPot; DigiPot_Vertical_SMD
U8: ULN2003A; SOIC-16_3.9x9.9mm_P1.27mm

Connections:
+5V: J4.2, K2.1, K4.1, K5.1, K6.1, PAN1.5 (VCC), R19.2, R20.2, R21.2, R22.2, R23.2, R24.2, U1.10 (VCC), U2.10 (VCC), U3.10 (VCC), U4.10 (VCC), U5.10 (VCC), U6.10 (VCC), U7.10 (VCC), U8.9 (COM); also elsewhere on the board
A1: J2.2, U2.1 (PA0), U4.1 (PA0), U5.1 (PA0), U6.1 (PA0)
A3: J2.1, U2.18 (PB1), U4.18 (PB1), U5.18 (PB1), U6.18 (PB1)
C: C9.1, U2.3 (PB0), U2.20 (PA1), U4.3 (PB0), U4.20 (PA1), U5.3 (PB0), U5.20 (PA1), U6.3 (PB0), U6.20 (PA1)
CHG: U1.11 (CHG), U2.11 (CHG), U3.11 (CHG), U4.11 (CHG), U5.11 (CHG), U6.11 (CHG), U7.11 (CHG); also elsewhere on the board
GND: C8.2, C9.2, J2.8, PAN1.4 (GND), U1.9 (GND), U1.12 (A2), U1.13 (A1), U1.14 (A0), U2.9 (GND), U2.12 (A2), U2.13 (A1), U3.9 (GND), U3.12 (A2), U3.14 (A0), U4.9 (GND), U4.12 (A2), U5.9 (GND), U5.13 (A1), U5.14 (A0), U6.9 (GND), U6.13 (A1), U7.9 (GND), U7.14 (A0), U8.8 (GND); also elsewhere on the board
HF1A: J2.6, U3.1 (PA0), U3.2 (PW0)
HF1B: J2.3, U3.19 (PW1), U3.20 (PA1)
HF3A: J2.7, U3.3 (PB0)
HF3B: J2.5, U3.18 (PB1)
HW: J2.4, K4.6
HW0: K4.7, U4.2 (PW0)
HW1: K4.5, U4.19 (PW1)
KBP: U8.1 (I1); also elsewhere on the board
KBP_SINK: J4.1, U8.16 (O1)
KHW: U8.4 (I4); also elsewhere on the board
KHW_SINK: K4.8, U8.13 (O4)
KLW: U8.2 (I2); also elsewhere on the board
KLW_SINK: K6.8, U8.15 (O2)
KMW: U8.5 (I5); also elsewhere on the board
KMW_SINK: K2.8, U8.12 (O5)
KPW: U8.3 (I3); also elsewhere on the board
KPW_SINK: K5.8, U8.14 (O3)
L1: J2.9, U7.1 (PA0)
L3: J2.10, U7.3 (PB0)
LW: J1.1, K6.6
LW0: K6.7, U6.2 (PW0)
LW1: K6.5, U6.19 (PW1)
MF1A: J1.5, U1.1 (PA0), U1.2 (PW0)
MF1B: J1.3, U1.19 (PW1), U1.20 (PA1)
MF3A: J1.6, U1.3 (PB0)
MF3B: J1.4, U1.18 (PB1)
MW: J1.7, K2.6
MW0: K2.7, U2.2 (PW0)
MW1: K2.5, U2.19 (PW1)
unnamed: C8.1, R25.2
unnamed: R19.1, U2.14 (A0)
unnamed: R20.1, U3.13 (A1)
unnamed: R21.1, U4.13 (A1), U4.14 (A0)
unnamed: R22.1, U5.12 (A2)
unnamed: R23.1, U6.12 (A2), U6.14 (A0)
unnamed: R24.1, U7.12 (A2), U7.13 (A1)
unnamed: R25.1, U7.2 (PW0)
PW: J1.2, K5.6
PW0: K5.7, U5.2 (PW0)
PW1: K5.5, U5.19 (PW1)
RE_A: PAN1.3 (RE_A); also elsewhere on the board
RE_B: PAN1.6 (RE_B); also elsewhere on the board
SCL: U1.15 (SCL), U2.15 (SCL), U3.15 (SCL), U4.15 (SCL), U5.15 (SCL), U6.15 (SCL), U7.15 (SCL); also elsewhere on the board
SDA: U1.16 (SDA), U2.16 (SDA), U3.16 (SDA), U4.16 (SDA), U5.16 (SDA), U6.16 (SDA), U7.16 (SDA); also elsewhere on the board
STORE_LED: PAN1.8 (LED); also elsewhere on the board
SW_LEFT: PAN1.1 (SW1); also elsewhere on the board
SW_RIGHT: PAN1.7 (SW2); also elsewhere on the board
SW_STORE: PAN1.2 (RE1); also elsewhere on the board

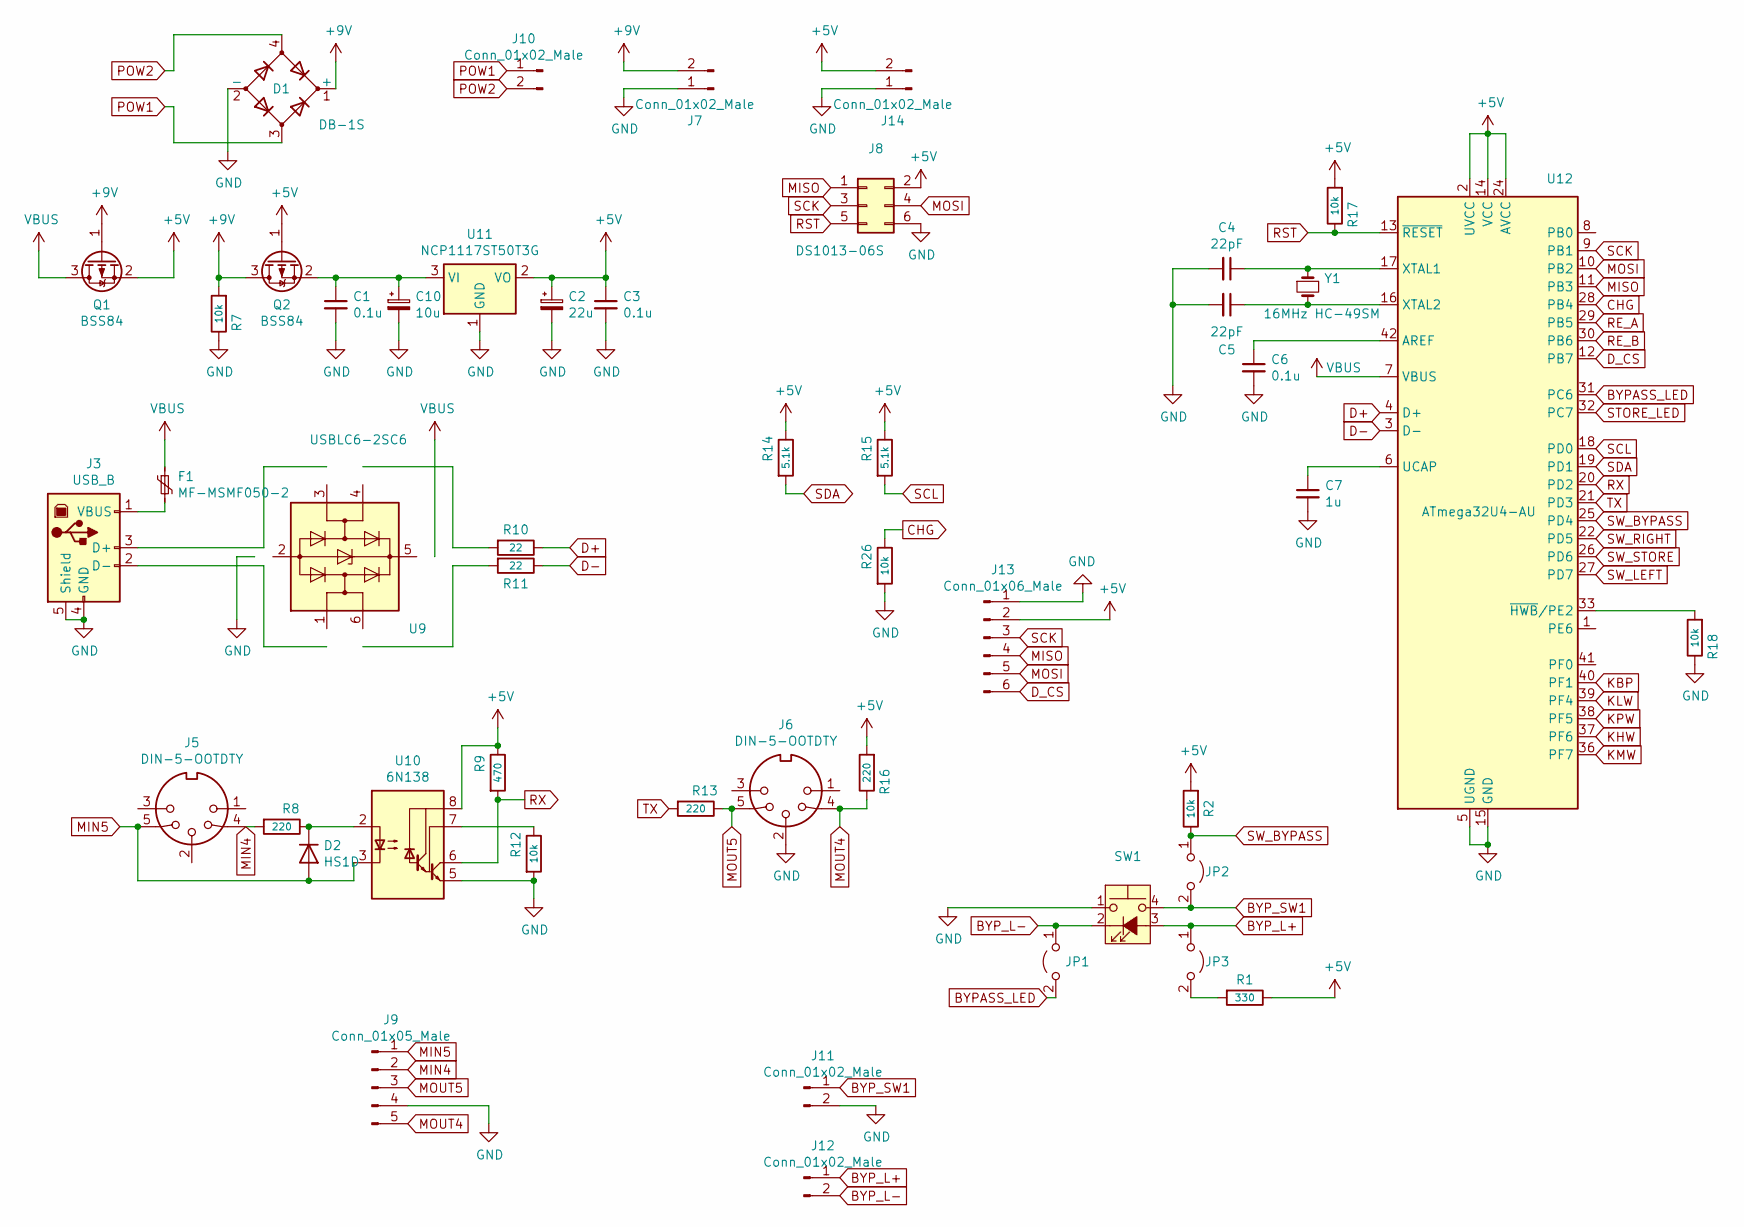
[picture p60: schematic atmega32u4.kicad_sch]

Parts:
C1, C3, C6: 0.1u; C_0805_2012Metric_Pad1.15x1.40mm_HandSolder
C2: 22u; CP_EIA-3528-21_Kemet-B_Pad1.50x2.35mm_HandSolder
C4, C5: 22pF; C_0805_2012Metric_Pad1.15x1.40mm_HandSolder
C7: 1u; C_0805_2012Metric_Pad1.15x1.40mm_HandSolder
C10: 10u; CP_EIA-3528-21_Kemet-B_Pad1.50x2.35mm_HandSolder
D1: DB-1S; Diode_Bridge_Vishay_DFS
D2: HS1D; D_SMA
F1: MF-MSMF050-2; Fuse_1812_4532Metric_Pad1.30x3.40mm_HandSolder
J3: USB_B; USB_B_OST_USB-B1HSxx_Horizontal
J5, J6: DIN-5-OOTDTY
J7, J10, J11, J12, J14: Conn_01x02_Male; JST_EH_B02B-EH-A_1x02_P2.50mm_Vertical
J8: DS1013-06S; IDC-Header_2x03_P2.54mm_Vertical
J9: Conn_01x05_Male; JST_EH_B05B-EH-A_1x05_P2.50mm_Vertical
J13: Conn_01x06_Male; JST_EH_B06B-EH-A_1x06_P2.50mm_Vertical
JP1, JP2, JP3: Jumper_NC_Small; PinHeader_1x02_P2.54mm_Vertical
Q1, Q2: BSS84; SOT-23
R1: 330; R_0805_2012Metric_Pad1.15x1.40mm_HandSolder
R2, R7, R12, R17, R18, R26: 10k; R_0805_2012Metric_Pad1.15x1.40mm_HandSolder
R8, R13, R16: 220; R_0805_2012Metric_Pad1.15x1.40mm_HandSolder
R9: 470; R_0805_2012Metric_Pad1.15x1.40mm_HandSolder
R10, R11: 22; R_0805_2012Metric_Pad1.15x1.40mm_HandSolder
R14, R15: 5.1k; R_0805_2012Metric_Pad1.15x1.40mm_HandSolder
SW1: SW_MEC_5G_LED; bypass_panel_THT
U9: USBLC6-2SC6; SOT-23-6
U10: 6N138; DIP-8_W8.89mm_SMDSocket_LongPads
U11: NCP1117ST50T3G; SOT-223-3_TabPin2
U12: ATmega32U4-AU; TQFP-44_10x10mm_P0.8mm
Y1: 16MHz HC-49SM; Crystal_SMD_HC49-SD

Connections:
+5V: C2.1, C3.1, J8.2, J13.2, J14.2, Q1.2 (S), Q2.1 (G), R1.1, R2.2, R9.1, R14.1, R15.1, R16.2, R17.2, U10.8 (VCC), U11.2 (VO), U12.2 (UVCC), U12.14 (VCC), U12.24 (AVCC), U12.34 (VCC), U12.44 (AVCC); also elsewhere on the board
+9V: D1.1 (+), J7.2, Q1.1 (G), Q2.3 (D), R7.2
BYPASS_LED: JP1.2 (B), U12.31 (PC6)
BYP_L+: J12.1, JP3.1 (A), SW1.3 (K)
BYP_L-: J12.2, JP1.1 (A), SW1.2
BYP_SW1: J11.1, JP2.2 (B), SW1.4 (A)
CHG: R26.1, U12.28 (PB4); also elsewhere on the board
D+: R10.1, U12.4 (D+)
D-: R11.1, U12.3 (D-)
D_CS: J13.6, U12.12 (PB7)
GND: C1.2, C2.2, C3.2, C4.2, C5.2, C6.2, C7.2, C10.2, D1.2 (-), J3.4 (GND), J3.5 (Shield), J6.2, J7.1, J8.6, J9.4, J11.2, J13.1, J14.1, R7.1, R12.2, R18.1, R26.2, SW1.1, U9.2 (GND), U10.5 (GND), U11.1 (GND), U12.5 (UGND), U12.15 (GND), U12.23 (GND), U12.35 (GND), U12.43 (GND); also elsewhere on the board
KBP: U12.40 (PF1); also elsewhere on the board
KHW: U12.37 (PF6); also elsewhere on the board
KLW: U12.39 (PF4); also elsewhere on the board
KMW: U12.36 (PF7); also elsewhere on the board
KPW: U12.38 (PF5); also elsewhere on the board
MIN4: J5.4, J9.2, R8.2
MIN5: D2.2 (A), J5.5, J9.1, U10.3 (C2)
MISO: J8.1, J13.4, U12.11 (PB3)
MOSI: J8.4, J13.5, U12.10 (PB2)
MOUT4: J6.4, J9.5, R16.1
MOUT5: J6.5, J9.3, R13.1
unnamed: C1.1, C10.1, Q2.2 (S), U11.3 (VI)
unnamed: C4.1, U12.17 (XTAL1), Y1.1
unnamed: C5.1, U12.16 (XTAL2), Y1.2
unnamed: C6.1, U12.42 (AREF)
unnamed: C7.1, U12.6 (UCAP)
unnamed: D2.1 (K), R8.1, U10.2 (C1)
unnamed: F1.2, J3.1 (VBUS)
unnamed: J3.2 (D-), U9.1 (I/O1)
unnamed: J3.3 (D+), U9.3 (I/O2)
unnamed: JP3.2 (B), R1.2
unnamed: R10.2, U9.4 (I/O2)
unnamed: R11.2, U9.6 (I/O1)
unnamed: R12.1, U10.7 (VO1)
unnamed: R18.2, U12.33 (~HWB/PE2)
POW1: D1.3, J10.1
POW2: D1.4, J10.2
RE_A: U12.29 (PB5); also elsewhere on the board
RE_B: U12.30 (PB6); also elsewhere on the board
RST: J8.5, R17.1, U12.13 (~RESET)
RX: R9.2, U10.6 (VO2), U12.20 (PD2)
SCK: J8.3, J13.3, U12.9 (PB1)
SCL: R15.2, U12.18 (PD0); also elsewhere on the board
SDA: R14.2, U12.19 (PD1); also elsewhere on the board
STORE_LED: U12.32 (PC7); also elsewhere on the board
SW_BYPASS: JP2.1 (A), R2.1, U12.25 (PD4)
SW_LEFT: U12.27 (PD7); also elsewhere on the board
SW_RIGHT: U12.22 (PD5); also elsewhere on the board
SW_STORE: U12.26 (PD6); also elsewhere on the board
TX: R13.2, U12.21 (PD3)
VBUS: F1.1, Q1.3 (D), U9.5 (VBUS), U12.7 (VBUS)

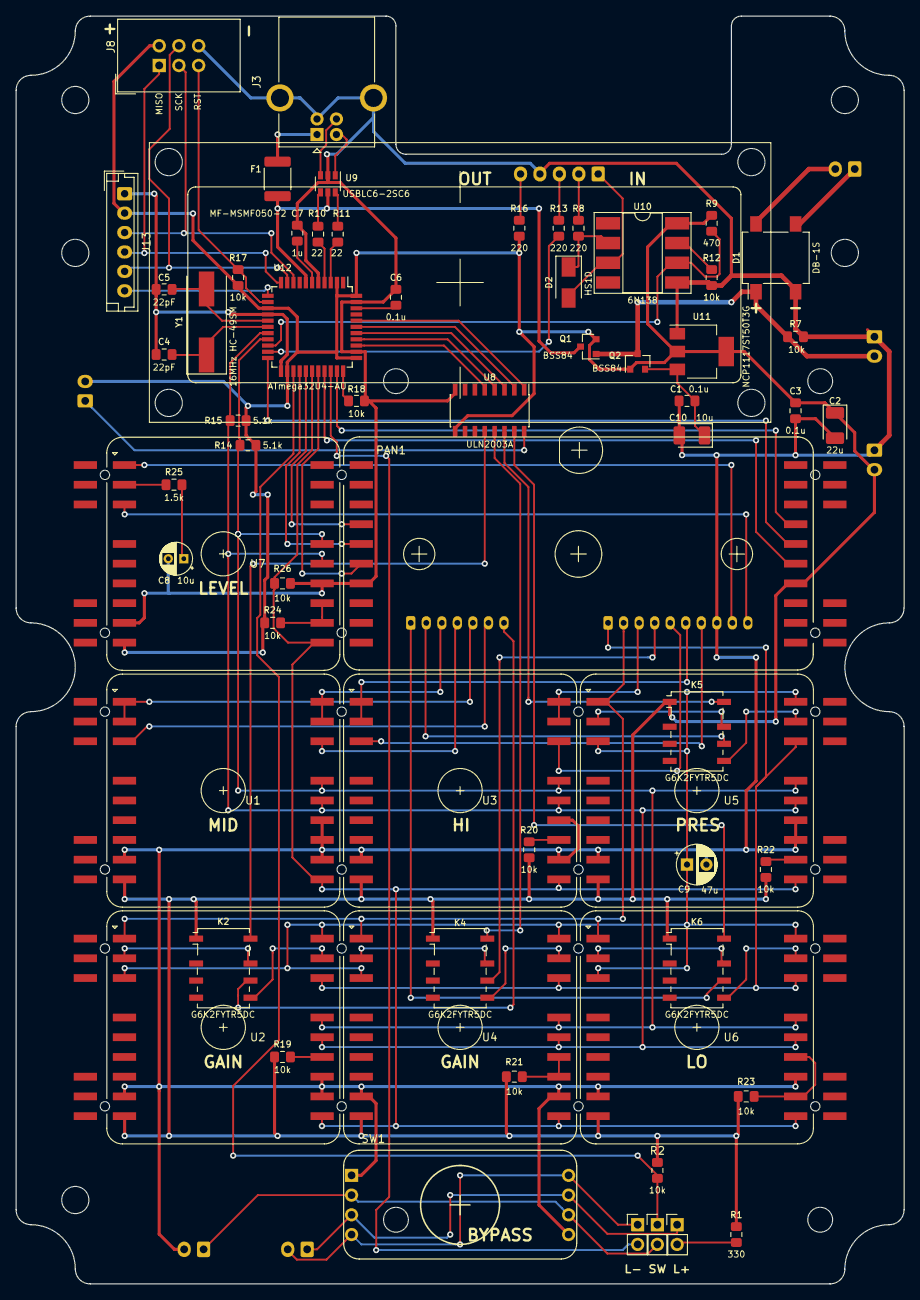
[picture p61: board digi_pot_eval_board.kicad_pcb from above]

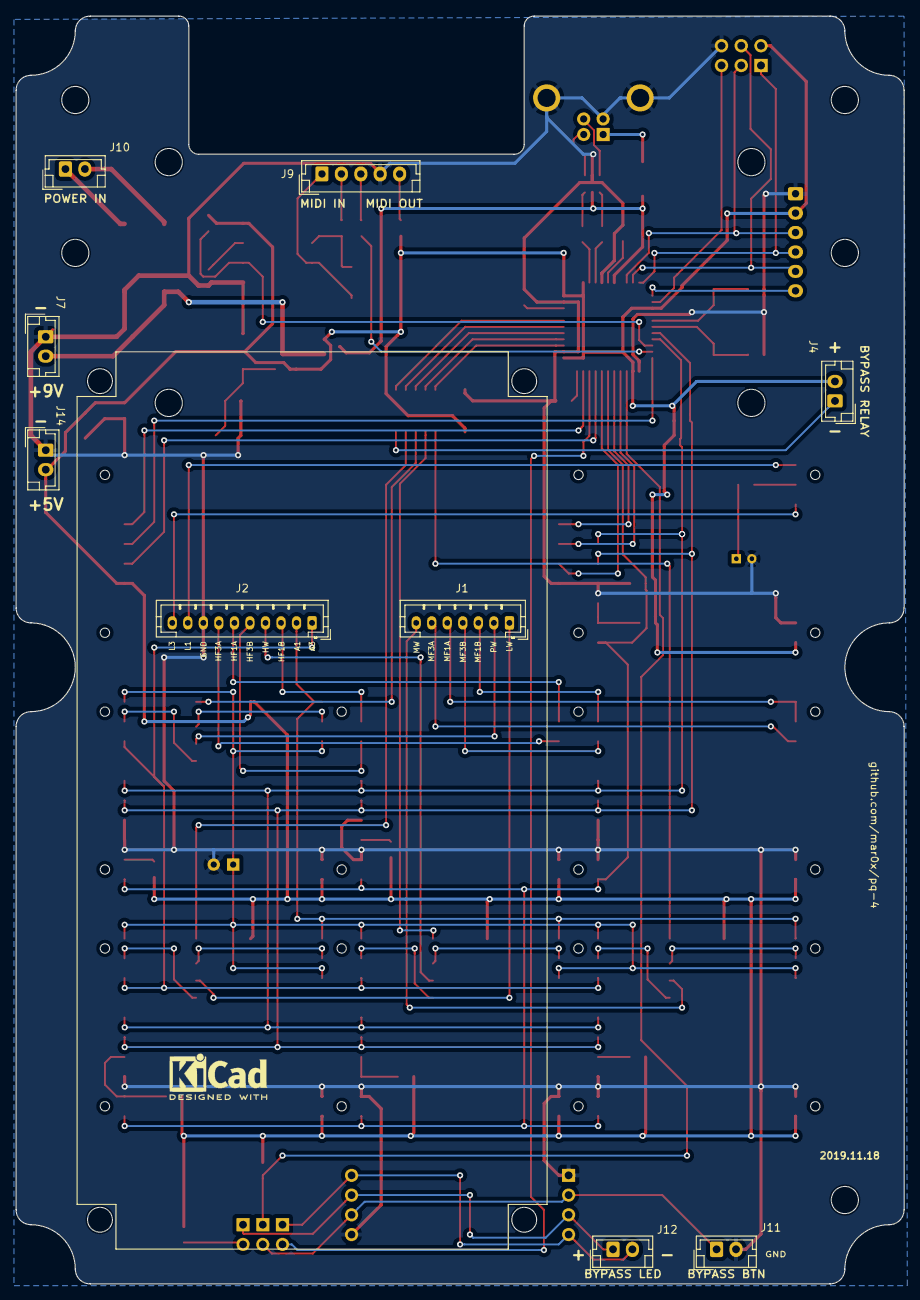
[picture p62: board digi_pot_eval_board.kicad_pcb from below]

Board: 2 copper layers, 114.3 x 163.2 mm, 71 parts (9 on the bottom side), 90 nets.
