mar0x/pq-4/digi_pot/digi_pot.kicad_pcb

## KiCad design digi_pot/digi_pot.kicad_pcb (2024-01-06)

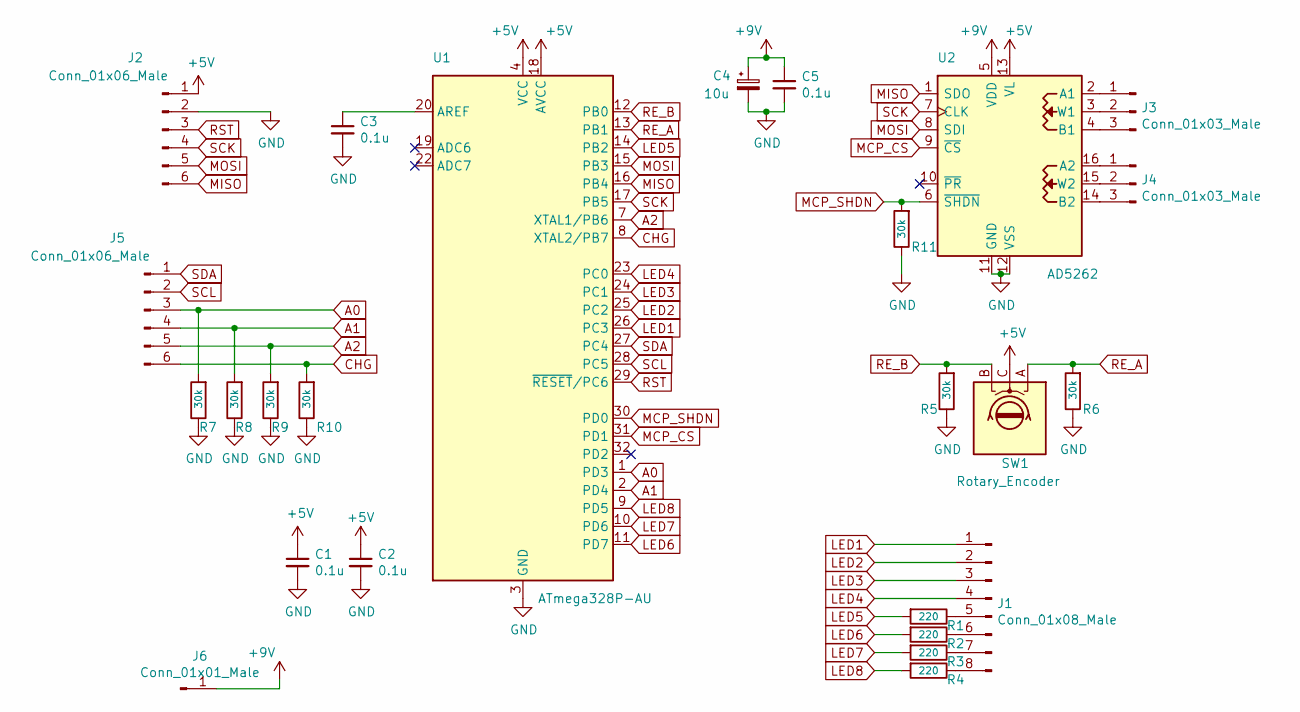
[picture p63: schematic digi_pot.kicad_sch]

Parts:
C1, C2, C3, C5: 0.1u; C_0805_2012Metric_Pad1.15x1.40mm_HandSolder
C4: 10u; CP_EIA-3216-18_Kemet-A_Pad1.58x1.35mm_HandSolder
J1: Conn_01x08_Male; Annular_LED_Ring
J2, J5: Conn_01x06_Male; PinHeader_1x06_P2.54mm_Vertical
J3, J4: Conn_01x03_Male; PinHeader_1x03_P2.54mm_Vertical
J6: Conn_01x01_Male; PinHeader_1x01_P2.54mm_Vertical
R1, R2, R3, R4: 220; R_0805_2012Metric_Pad1.15x1.40mm_HandSolder
R5, R6, R7, R8, R9, R10, R11: 30k; R_0805_2012Metric_Pad1.15x1.40mm_HandSolder
SW1: Rotary_Encoder; RotaryEncoder_Alps_EC12E_Vertical_H20mm
U1: ATmega328P-AU; TQFP-32_7x7mm_P0.8mm
U2: AD5262; TSSOP-16_4.4x5mm_P0.65mm

Connections:
+5V: C1.1, C2.1, J2.1, SW1.C, U1.4 (VCC), U1.6 (VCC), U1.18 (AVCC), U2.13 (VL)
+9V: C4.1, C5.1, J6.1, U2.5 (VDD)
A0: J5.3, R7.2, U1.1 (PD3)
A1: J5.4, R8.2, U1.2 (PD4)
A2: J5.5, R9.2, U1.7 (XTAL1/PB6)
CHG: J5.6, R10.2, U1.8 (XTAL2/PB7)
GND: C1.2, C2.2, C3.2, C4.2, C5.2, J2.2, R5.1, R6.1, R7.1, R8.1, R9.1, R10.1, R11.1, U1.3 (GND), U1.5 (GND), U1.21 (GND), U2.11 (GND), U2.12 (VSS)
LED1: J1.1, U1.26 (PC3)
LED2: J1.2, U1.25 (PC2)
LED3: J1.3, U1.24 (PC1)
LED4: J1.4, U1.23 (PC0)
LED5: R1.2, U1.14 (PB2)
LED6: R2.2, U1.11 (PD7)
LED7: R3.2, U1.10 (PD6)
LED8: R4.2, U1.9 (PD5)
MCP_CS: U1.31 (PD1), U2.9 (~CS)
MCP_SHDN: R11.2, U1.30 (PD0), U2.6 (~SHDN)
MISO: J2.6, U1.16 (PB4), U2.1 (SDO)
MOSI: J2.5, U1.15 (PB3), U2.8 (SDI)
unnamed: C3.1, U1.20 (AREF)
unnamed: J1.5, R1.1
unnamed: J1.6, R2.1
unnamed: J1.7, R3.1
unnamed: J1.8, R4.1
unnamed: J3.1, U2.2 (A1)
unnamed: J3.2, U2.3 (W1)
unnamed: J3.3, U2.4 (B1)
unnamed: J4.1, U2.16 (A2)
unnamed: J4.2, U2.15 (W2)
unnamed: J4.3, U2.14 (B2)
RE_A: R6.2, SW1.A, U1.13 (PB1)
RE_B: R5.2, SW1.B, U1.12 (PB0)
RST: J2.3, U1.29 (~RESET/PC6)
SCK: J2.4, U1.17 (PB5), U2.7 (CLK)
SCL: J5.2, U1.28 (PC5)
SDA: J5.1, U1.27 (PC4)

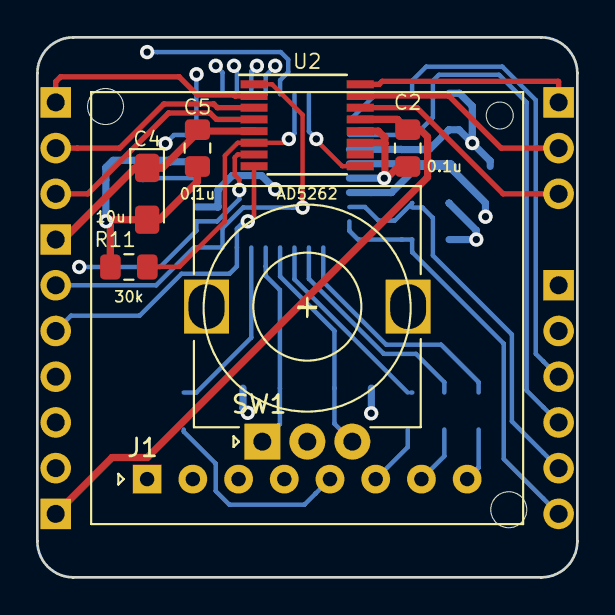
[picture p64: board digi_pot.kicad_pcb from above]

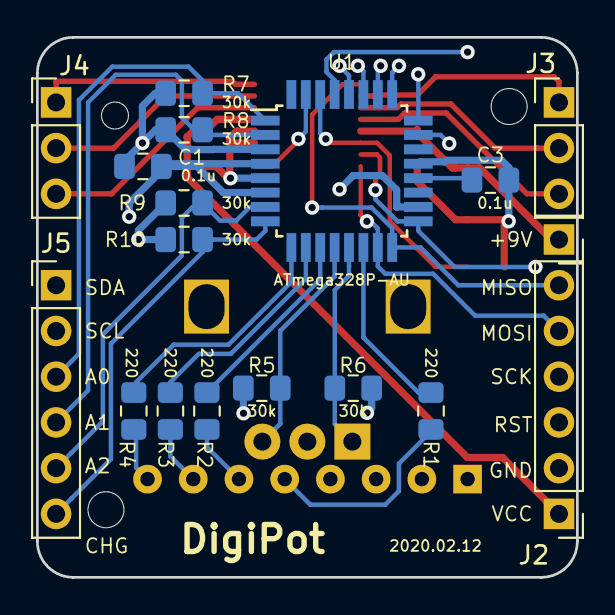
[picture p65: board digi_pot.kicad_pcb from below]

Board: 4 copper layers, 30.0 x 30.0 mm, 25 parts (18 on the bottom side), 36 nets.
