mar0x/pq-4/socket_board/socket_board.kicad_pcb

## KiCad design socket_board/socket_board.kicad_pcb (2024-01-06)

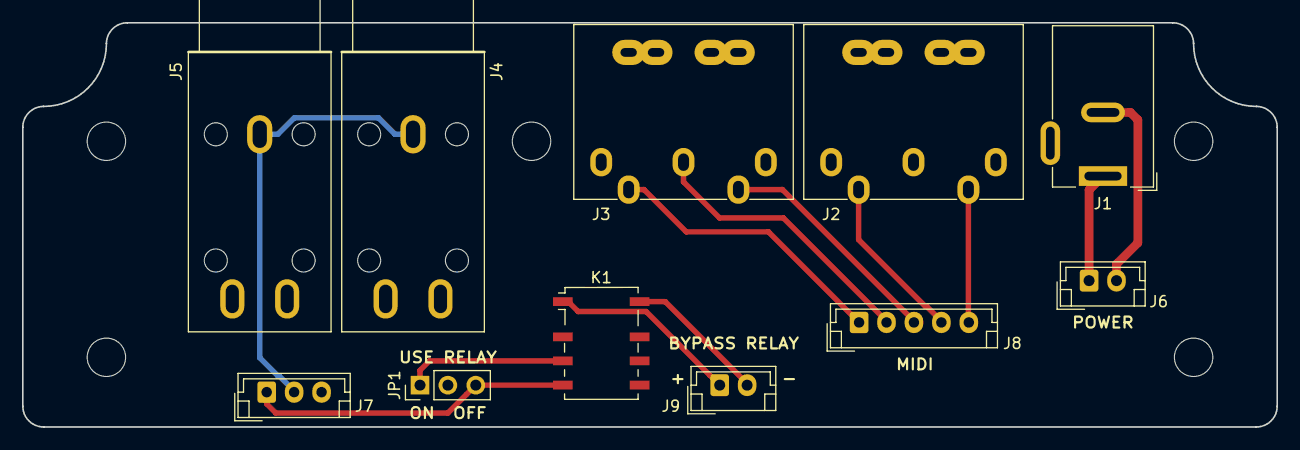
[picture p66: board socket_board.kicad_pcb from above]

Board: 2 copper layers, 114.3 x 36.8 mm, 11 parts (0 on the bottom side), 14 nets.

Parts:
J1: Barrel_Jack_Switch; BarrelJack_Wuerth_6941xx301002
J2, J3: DIN-5_180degree; DIN5MIDI-OOTDTY
J4, J5: AudioJack3; phone-jack-6.3
J6, J9: Conn_01x02_Male; JST_EH_B02B-EH-A_1x02_P2.50mm_Vertical
J7: Conn_01x03_Male; JST_EH_B03B-EH-A_1x03_P2.50mm_Vertical
J8: Conn_01x05_Male; JST_EH_B05B-EH-A_1x05_P2.50mm_Vertical
JP1: Jumper_3_Bridged12; PinHeader_1x03_P2.54mm_Vertical
K1: G6K-2; Relay_DPDT_Omron_G6K-2F-Y

Connections:
GND: J4.S, J5.S, J7.2
IN_T: J4.T, J7.3, K1.2
MIN_4: J2.4, J8.4
MIN_5: J2.5, J8.5
MOUT_2: J3.2, J8.2
MOUT_4: J3.4, J8.1
MOUT_5: J3.5, J8.3
unnamed: J5.T, JP1.2
unnamed: JP1.1, K1.3
OUT_T: J7.1, JP1.3, K1.4
POW1: J1.1, J6.1
POW2: J1.2, J6.2
REL+: J9.1, K1.1
REL-: J9.2, K1.8
