mar0x/pq-4/nav_panel/nav_panel.kicad_pcb

## KiCad design nav_panel/nav_panel.kicad_pcb (2019-12-06)

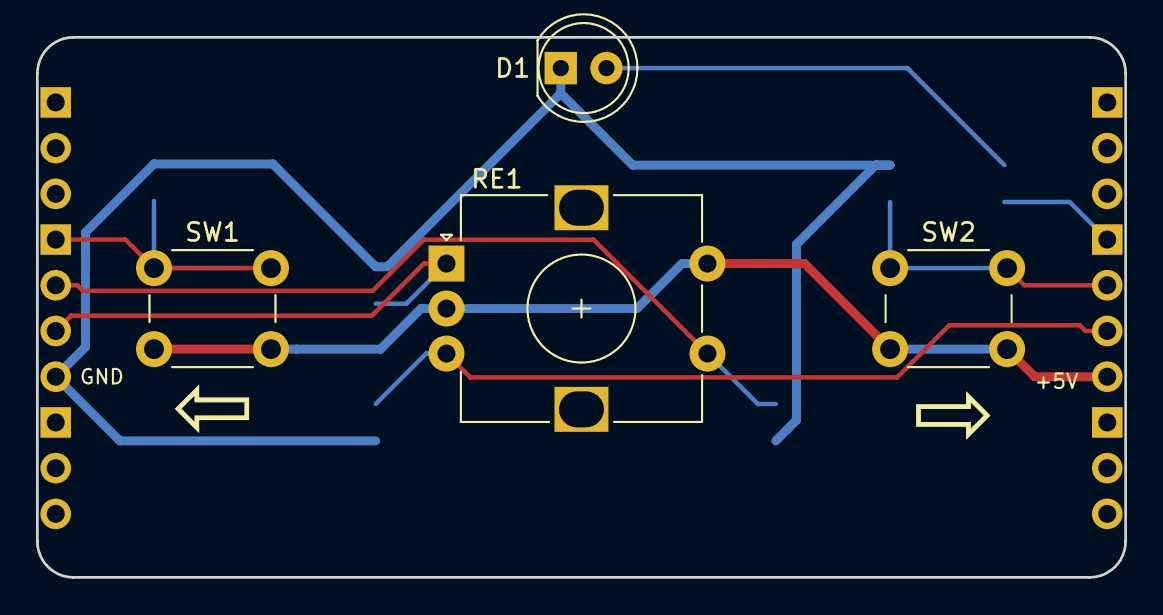
[picture p67: board nav_panel.kicad_pcb from above]

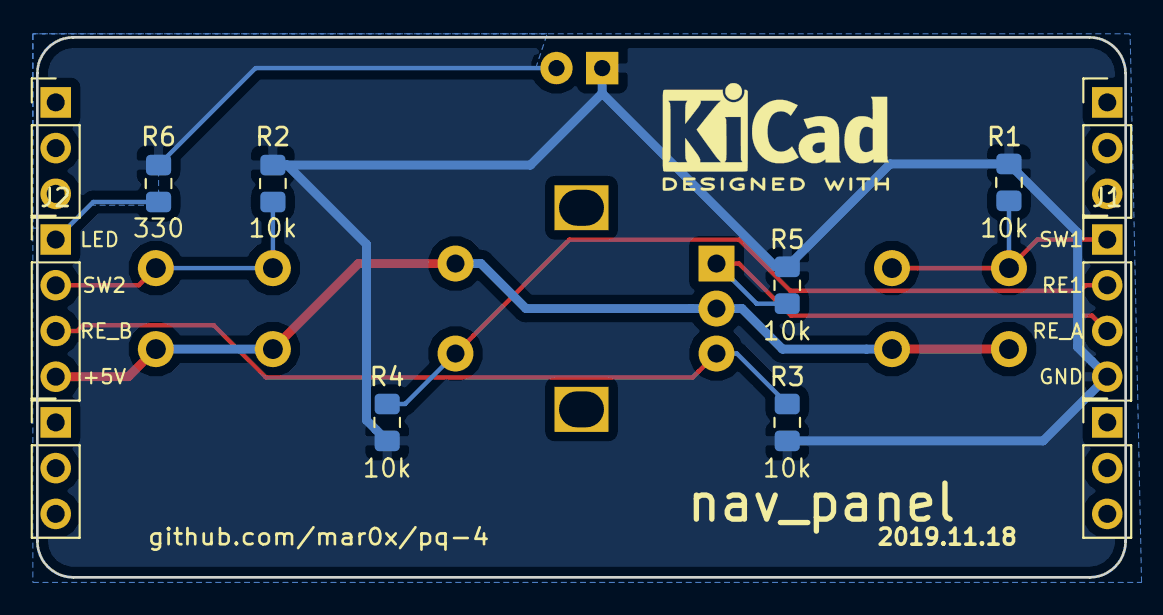
[picture p68: board nav_panel.kicad_pcb from below]

Board: 2 copper layers, 60.5 x 30.0 mm, 12 parts (8 on the bottom side), 9 nets.

Parts:
D1: LED; LED_D5.0mm
J1, J2: Conn_01x04_Male; PinHeader_1x04_P2.54mm_Vertical
R1, R2, R3, R4, R5: 10k; R_0805_2012Metric_Pad1.15x1.40mm_HandSolder
R6: 330; R_0805_2012Metric_Pad1.15x1.40mm_HandSolder
RE1: Rotary_Encoder_Switch; RotaryEncoder_Alps_EC12E-Switch_Vertical_H20mm
SW1, SW2: SW_Push; SW_PUSH_6mm_H5mm

Connections:
+5V: J2.4, RE1.C, RE1.S1, SW1.2, SW2.2
GND: D1.1, J1.4, R1.2, R2.2, R3.2, R4.2, R5.2
LED: J2.1, R6.2
unnamed: D1.2, R6.1
RE1: J1.2, R4.1, RE1.S2
RE_A: J1.3, R5.1, RE1.A
RE_B: J2.3, R3.1, RE1.B
SW1: J1.1, R1.1, SW1.1
SW2: J2.2, R2.1, SW2.1
