mar0x/pq-4/bypass_panel/bypass_panel.kicad_pcb

## KiCad design bypass_panel/bypass_panel.kicad_pcb (2019-11-18)

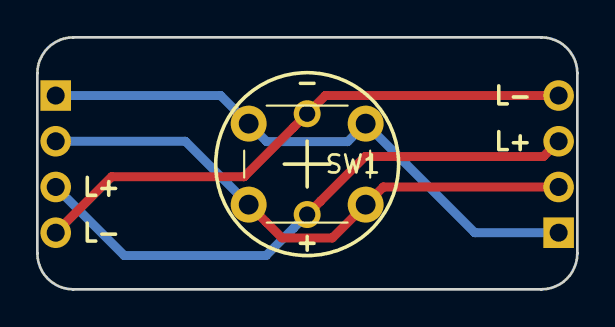
[picture p69: board bypass_panel.kicad_pcb from above]

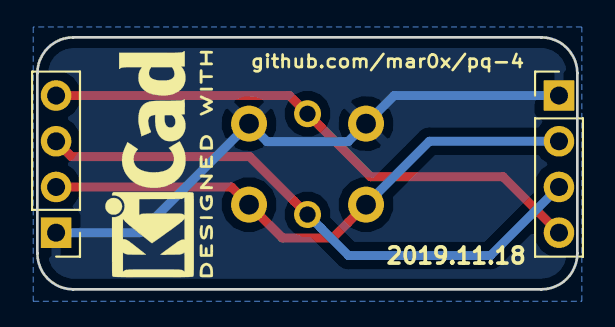
[picture p70: board bypass_panel.kicad_pcb from below]

Board: 2 copper layers, 30.0 x 14.0 mm, 3 parts (2 on the bottom side), 4 nets.

Parts:
J1, J2: Conn_01x04_Male; PinHeader_1x04_P2.54mm_Vertical
SW1: SW_MEC_5G_LED; SW_PUSH_6mm

Connections:
B1: J1.1, J2.1, SW1.1
B2: J1.2, J2.2, SW1.4
L+: J1.3, J2.3, SW1.3
L-: J1.4, J2.4, SW1.2
