mar0x/pq-4/enc_panel/enc_panel.kicad_pcb

## KiCad design enc_panel/enc_panel.kicad_pcb (2019-08-10)

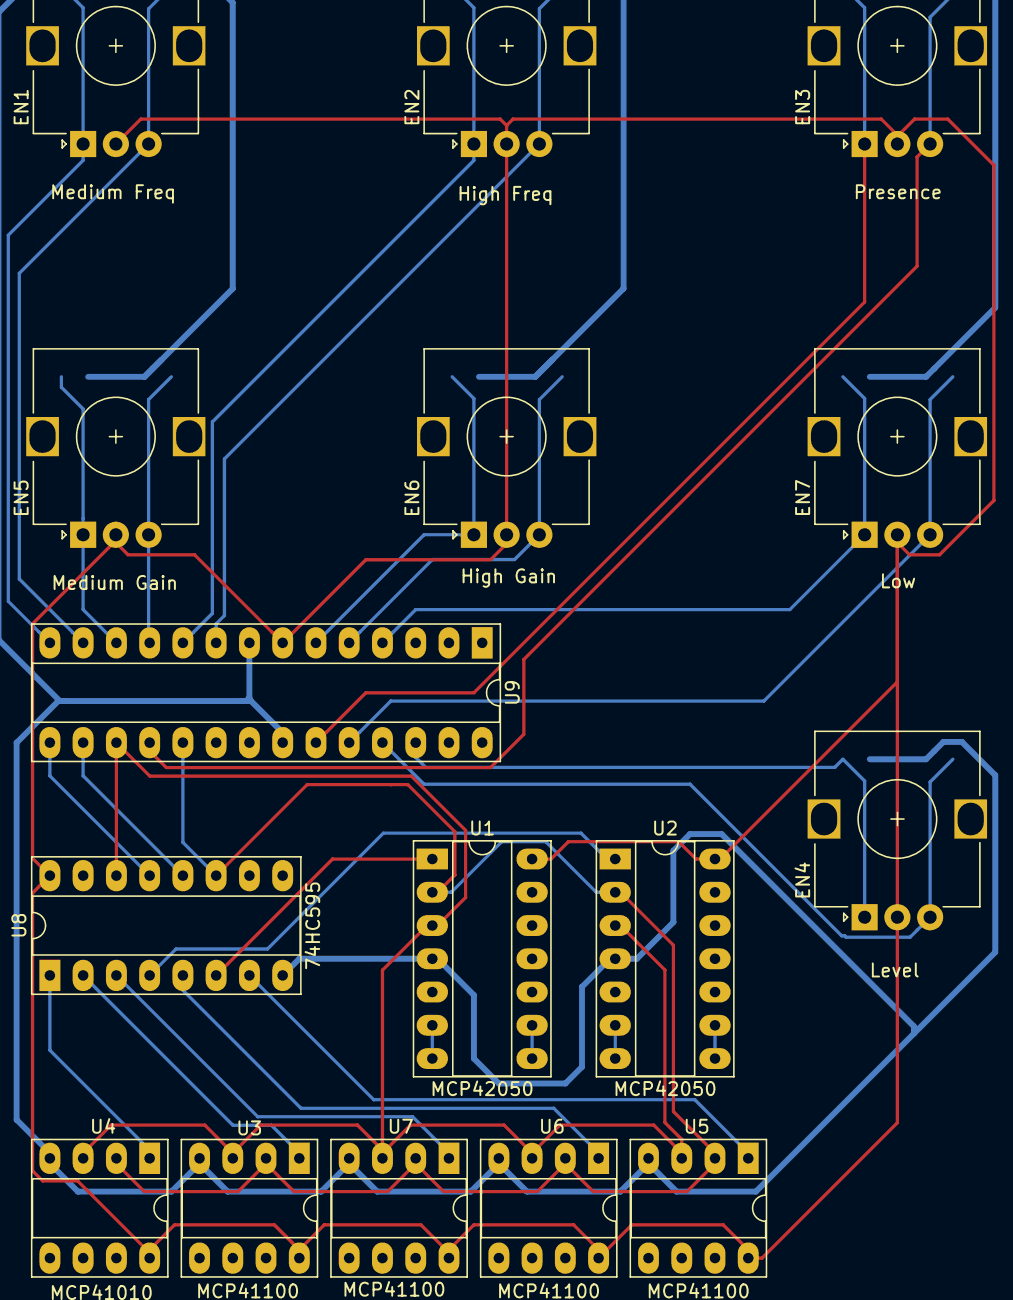
[picture p71: board enc_panel.kicad_pcb from above]

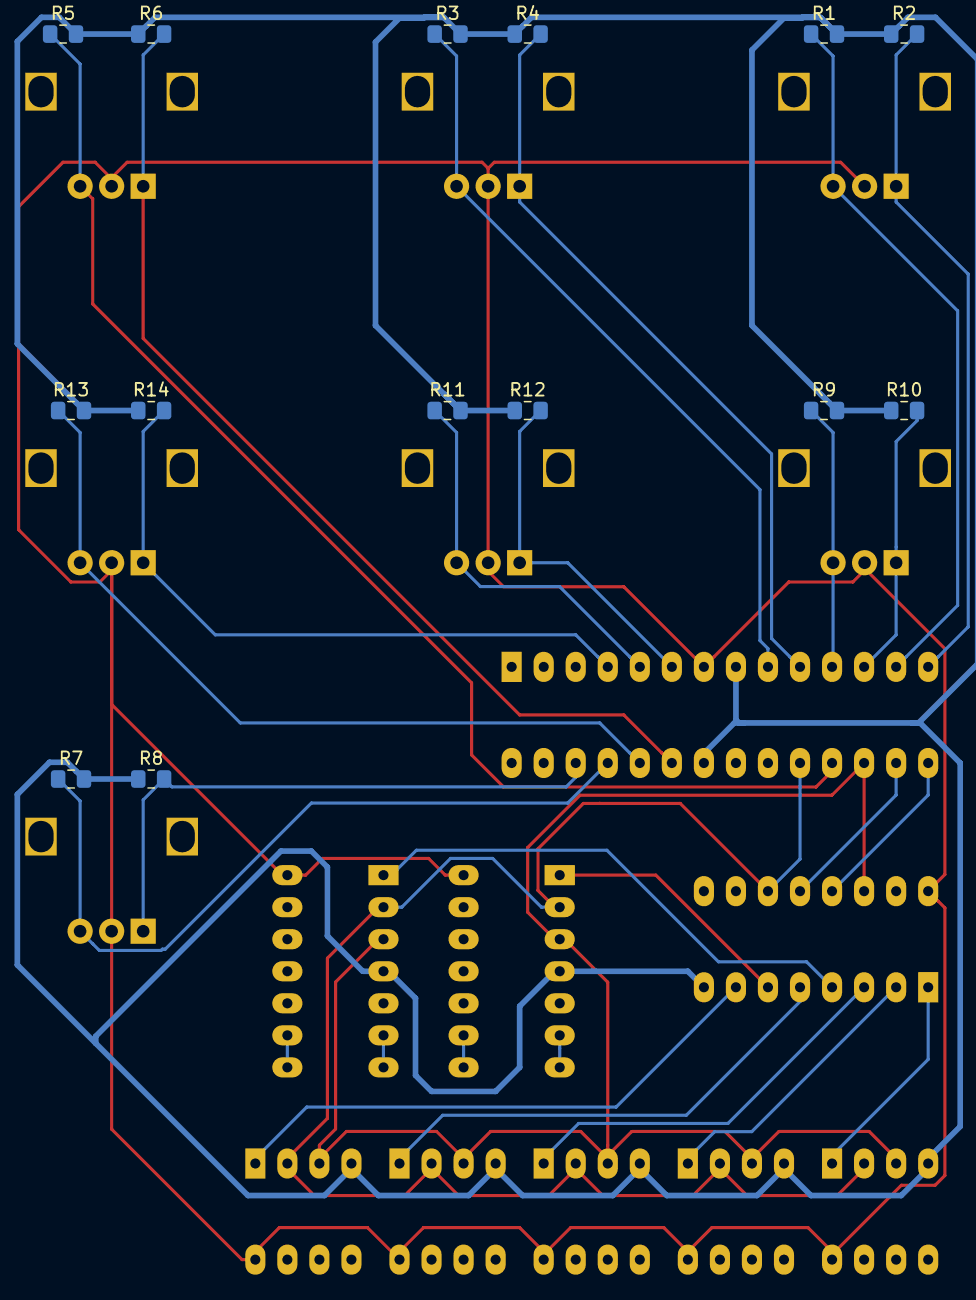
[picture p72: board enc_panel.kicad_pcb from below]

Board: 2 copper layers, 30 parts (14 on the bottom side), 31 nets.

Parts:
EN1: Medium Freq; RotaryEncoder_Alps_EC12E_Vertical_H20mm
EN2: High Freq; RotaryEncoder_Alps_EC12E_Vertical_H20mm
EN3: Presence; RotaryEncoder_Alps_EC12E_Vertical_H20mm
EN4: Level; RotaryEncoder_Alps_EC12E_Vertical_H20mm
EN5: Medium Gain; RotaryEncoder_Alps_EC12E_Vertical_H20mm
EN6: High Gain; RotaryEncoder_Alps_EC12E_Vertical_H20mm
EN7: Low; RotaryEncoder_Alps_EC12E_Vertical_H20mm
R1, R2, R3, R4, R5, R6, R7, R8, R9, R10, R11, R12, R13, R14: 10k; R_0805_2012Metric_Pad1.15x1.40mm_HandSolder
U1, U2: MCP42050; DIP-14_W7.62mm_Socket_LongPads
U3, U5, U6, U7: MCP41100; DIP-8_W7.62mm_Socket_LongPads
U4: MCP41010; DIP-8_W7.62mm_Socket_LongPads
U8: 74HC595; DIP-16_W7.62mm_Socket_LongPads
U9: ATmega328P-PU; DIP-28_W7.62mm_Socket_LongPads

Connections:
+5V: EN1.C, EN2.C, EN3.C, EN4.C, EN5.C, EN6.C, EN7.C, U1.14, U2.14, U3.8, U4.8, U5.8, U6.8, U7.8, U8.16, U9.7
E1A: EN1.A, R2.2, U9.14
E1B: EN1.B, R1.1, U9.13
E2A: EN2.A, R4.2, U9.10
E2B: EN2.B, R3.1, U9.9
E3A: EN3.A, R6.2, U9.23
E3B: EN3.B, R5.1, U9.18
E4A: EN4.A, R8.2, U9.26
E4B: EN4.B, R7.1, U9.25
E5A: EN5.A, R10.2, U9.12
E5B: EN5.B, R9.1, U9.11
E6A: EN6.A, R12.2, U9.6
E6B: EN6.B, R11.1, U9.5
E7A: EN7.A, R14.2, U9.4
E7B: EN7.B, R13.1, U9.24
GND: R1.2, R2.1, R3.2, R4.1, R5.2, R6.1, R7.2, R8.1, R9.2, R10.1, R11.2, R12.1, R13.2, R14.1, U1.4, U2.4, U3.4, U4.4, U5.4, U6.4, U7.4, U8.8, U9.8, U9.22
HF11: U2.8, U2.9
HF21: U2.6, U2.7
MF11: U1.8, U1.9
MF21: U1.6, U1.7
OE: U8.13, U9.15
QB: U4.1, U8.1
QC: U3.1, U8.2
QD: U7.1, U8.3
QE: U2.1, U8.4
QF: U6.1, U8.5
QG: U1.1, U8.6
QH: U5.1, U8.7
SCK: U1.2, U2.2, U3.2, U4.2, U5.2, U6.2, U7.2, U8.11, U9.19
SI: U1.3, U2.3, U3.3, U4.3, U5.3, U6.3, U7.3, U8.14, U9.17
SS: U8.12, U9.16
