mar0x/pq-4/(commit log)

2019-08-10 Initial commit.
    [center-tap-pot.sch, enc_panel.kicad_pcb, enc_panel.sch, mini_panel.kicad_pcb, mini_panel.sch, pq-4-pot.FCStd, pq-4.kicad_pcb, pq-4.sch]
2019-09-11 Minor improvements.
    [pq-4.kicad_pcb, pq-4.sch]
2019-09-23 Updating schema layout.
    [pq-4.sch]
2019-09-23 Introducing DigiPot mini-board.
    [digi_pot-B.Cu.gbr, digi_pot-B.Mask.gbr, digi_pot-B.Paste.gbr, digi_pot-B.SilkS.gbr, digi_pot-Edge.Cuts.gbr, digi_pot-F.Cu.gbr, digi_pot-F.Mask.gbr, digi_pot-F.Paste.gbr]
2019-10-09 External panels added
    [atmega32u4.sch, digi_pot_eval_board.kicad_pcb, digi_pot_eval_board.sch, eq_test_board.kicad_pcb, eq_test_board.sch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]
2019-10-16 Added pin definition for PB6 & PB7.
    Usually this pins used for external crystal and not used in Arduino.
2019-10-16 Fixing A2 pin definition.
    [digi_pot.ino]
2019-10-16 Introducing 3D model for Annular LED Ring.
2019-10-16 Adding draft encoder 3D model.
2019-10-16 Using 3D models for Annular LED Ring and encoder.
    [digi_pot.kicad_pcb]
2019-10-16 Fixing MIDI optocoupler protection diode footprint.
    [atmega32u4.sch, digi_pot_eval_board.kicad_pcb, digi_pot_eval_board.sch]
2019-10-18 Shutdown pull down resistor labels aligned.
    [digi_pot.sch]
2019-10-27 EC12E encoder 3D model added.
    [digi_pot.kicad_pcb]
2019-10-27 Wide nav_panel version.
    [nav_panel.kicad_pcb]
2019-10-27 DIN-5 MIDI female connector 3D model draft added.
2019-10-27 Jack 6.3mm footprint added.
2019-10-27 Before wide nav_panel and Level pot move.
    [atmega32u4.sch, digi_pot_eval_board.kicad_pcb, digi_pot_eval_board.sch]
2019-10-27 Introducing socket board.
    [socket_board.kicad_pcb, socket_board.sch]
2019-10-31 Added OLED 1602 module footprint.
2019-10-31 Introducing BOM text file.
2019-10-31 Adjusting socket board dimensions.
    [socket_board.kicad_pcb, socket_board.sch]
2019-10-31 Introducing new layout.
    [atmega32u4.sch, digi_pot_eval_board.kicad_pcb, digi_pot_eval_board.sch]
2019-11-13 Introducing bypass panel with LED button.
    [bypass_panel.kicad_pcb, bypass_panel.sch]
2019-11-13 Printed and tested layout version.
    USB still on upper board.
    [atmega32u4.sch, digi_pot.kicad_pcb, digi_pot_eval_board.kicad_pcb, digi_pot_eval_board.sch, nav_panel.kicad_pcb, socket_board.kicad_pcb, socket_board.sch]
2019-11-18 Removing gerber files from source control.
    [digi_pot-B.Cu.gbr, digi_pot-B.Mask.gbr, digi_pot-B.Paste.gbr, digi_pot-B.SilkS.gbr, digi_pot-Edge.Cuts.gbr, digi_pot-F.Cu.gbr, digi_pot-F.Mask.gbr, digi_pot-F.Paste.gbr]
2019-11-18 Production version 2019.11.19.
    [atmega32u4.sch, bypass_panel.kicad_pcb, digi_pot_eval_board.kicad_pcb, digi_pot_eval_board.sch, nav_panel.kicad_pcb, socket_board.kicad_pcb]
2019-12-05 Reverting Annular LED low profile to original height.
2019-12-05 Generating short pin headers for low profile boards.
2019-12-05 Generating DigiPot 3D model.
    [digi_pot.kicad_pcb]
2019-12-06 Adding 3D models.
    [digi_pot_eval_board.kicad_pcb, nav_panel.kicad_pcb, socket_board.kicad_pcb]
2019-12-06 Adding case 3D models.
2019-12-06 Adding board 3D model.
2019-12-25 Adding I2C communication.
2020-01-16 Diode bridge added.
2020-01-16 Introducing I2C registers.
2020-01-16 Upgrading KiCad and fixing ULN2003a connection.
    [atmega32u4.sch, digi_pot_eval_board.kicad_pcb, digi_pot_eval_board.sch]
2020-02-12 Changing pos <-> SPI command mapping.
    Highlight renamed to Red dot.
2020-02-12 Switching to AD5262 digital pot.
    [digi_pot.kicad_pcb, digi_pot.sch]
2020-02-12 Moving Annular LED holes by 0.2mm out.
2020-02-12 Using standard Atmega328 symbol.
    [digi_pot.kicad_pcb, digi_pot.sch]
2024-01-06 Switch to 8-bit pot value
2024-01-06 Phone Jack fix
    [socket_board.kicad_pcb]
2024-01-06 Minor schematic changes
    [atmega32u4.sch, digi_pot_eval_board.sch]
2024-01-06 Updating BOM
2024-01-06 digi_pot: switch to KiCad 7.0
    [digi_pot.kicad_pcb, digi_pot.kicad_sch, digi_pot.sch]
2024-01-06 digi_pot_eval_board: switch to KiCad 7.0
    [atmega32u4.kicad_sch, atmega32u4.sch, digi_pot_eval_board.kicad_pcb, digi_pot_eval_board.kicad_sch, digi_pot_eval_board.sch]
2024-01-06 pq-4: switch to KiCad 7.0
    [pq-4.kicad_pcb, pq-4.kicad_sch, pq-4.sch]
2024-01-06 Updated schematic
2024-01-09 Introducing POT board
    [pot_board.kicad_pcb, pot_board.kicad_sch]
2024-01-14 Working on POT Board
    [pot_board.kicad_pcb, pot_board.kicad_sch]
